marcelo-carvalhop/iot-over-can/Documentacao/historico/README.md

# Histórico

Documentos de etapas anteriores do projeto, guardados como foram escritos, sem revisão. Podem citar arquivos, comandos e comportamentos que já mudaram e caminhos que não existem mais. A documentação em vigor está em [`Documentacao/`](../).

| Documento | Conteúdo |
|---|---|
| [`bancada-fisica-2026-10-08.md`](bancada-fisica-2026-10-08.md) | primeira sessão do canal de dados na bancada física |
| [`auditoria-integrada-2026-10.md`](auditoria-integrada-2026-10.md) | auditoria de robustez de outubro de 2026 |
| [`proposta-comissionamento-de-sensores.md`](proposta-comissionamento-de-sensores.md) | proposta, não implementada, de entregar a chave ao sensor pela rede |
| [`simulacao-etapas-2-e-3.md`](simulacao-etapas-2-e-3.md) | laboratório virtual: TUI ligada à bancada e topologia mutável |
| [`simulacao-studio-etapa-4.md`](simulacao-studio-etapa-4.md) | Simulation Studio |
| [`simulacao-ponte-usb-etapa-5.md`](simulacao-ponte-usb-etapa-5.md) | ponte USB para sensores reais |
| [`simulacao-ponte-usb-fft-etapa-6.md`](simulacao-ponte-usb-fft-etapa-6.md) | espectro do sensor acústico pela ponte USB |
| [`simulacao-iniciar-laboratorio.md`](simulacao-iniciar-laboratorio.md) | lançador do laboratório em três terminais |
| [`tui-historico-etapa-1.md`](tui-historico-etapa-1.md) | histórico de sessões na estação |
| [`tui-capturas-etapa-2.md`](tui-capturas-etapa-2.md) | capturas de contexto na estação |
| [`img/`](img/) | capturas de tela de uma versão anterior da estação |
