marcelo-carvalhop/iot-over-can/Documentacao/desafios.md

# Desafios e resoluções

Problemas técnicos que já apareceram no projeto, com a causa e a solução. Serve para entender decisões que, vistas isoladamente, parecem excesso de cuidado, e para reconhecer um problema que volte a aparecer.

Cada problema tem um número `CH-` único. Entram aqui problemas com impacto na arquitetura, no protocolo, na segurança, na compilação ou na operação; observações passageiras de bancada ficam no registro da sessão, em `historico/`.

| ID | Problema | Causa | Solução aplicada | Estado |
|---|---|---|---|---|
| CH-001 | DTCs conhecidos apareciam como desconhecidos | catálogo incompleto na TUI | catálogo explícito e fallback por categoria | Resolvido |
| CH-002 | bateria não instrumentada parecia 100% | sentinelas interpretadas como valor real | `255` e `65535` tratados como N/A | Resolvido |
| CH-003 | TUI dependia de porta serial no boot | inicialização acoplada ao transporte | inicialização offline e conexão posterior | Resolvido |
| CH-004 | IDs de Nodes podiam ser duplicados por build incorreto | valor de ID dependia de edição manual | ID explícito por script/`IOT_NODE_ID` | Resolvido |
| CH-005 | comandos mutáveis dependiam apenas da TUI | firmware aceitava ações locais sem sessão | `AUTH UNLOCK` e lease de administração no sensor | Resolvido |
| CH-006 | segredos estavam sujeitos a configuração inconsistente | múltiplas fontes e ausência de validação | `.env.local`, `security.json` 0600 e script de provisionamento | Resolvido |
| CH-007 | build do Pico W falhava ao ligar BTstack | configuração de hexdump ausente | `ENABLE_PRINTF_HEXDUMP` no `btstack_config.h` | Resolvido |
| CH-008 | Probe não respondia à autodetecção textual | parser aceitava apenas comandos CAN hexadecimais | `PROBE_VERSION` e `PROBE_STATUS` | Resolvido |
| CH-009 | EventLog era poluído por manutenção e telemetria | estado contínuo tratado como evento | classificação de manutenção e painel dedicado de Nodes | Resolvido |
| CH-010 | abertura serial podia produzir fragmentos e bytes NUL | dados residuais e handshake rápido demais | limpeza do buffer, atraso de estabilização e sanitização de entrada | Mitigado |
| CH-011 | associação wireless precisava preservar a escolha explícita do operador | um mesmo UUID pode ser visto por vários Nodes com RSSI diferente | vínculo lógico comandado pela TUI, confirmação pelo CAN e lease de presença por BLE; vínculos gravados na NVS (CH-069) | Resolvido |
| CH-012 | CAN ainda usa MCP2515 clássico | hardware CAN FD ainda não integrado | permanecer em CAN clássico por ora; segmentação em quadros maiores e mensagem autenticada preparadas em biblioteca ([Arquitetura](arquitetura.md#9-preparação-para-can-fd)) | Decidido |
| CH-013 | filho wireless aparecia `STALE/LOST` apesar de o Node continuar recebendo advertisements | TUI e Node CAN calculavam liveness de forma independente, e o lease BLE de 6,5 s era agressivo | Node CAN tornou-se autoridade de liveness, lease ajustado para 15/45 s, filtro de duplicatas desabilitado e watchdog de scan | Resolvido |
| CH-014 | TUI acumulava informação simultânea e dependia de atalhos/comandos pouco visíveis | topologia, telemetria, configuração, eventos e comandos disputavam a mesma tela; ações equivalentes existiam em vários caminhos | telas cheias por assunto, barra contextual, catálogo único de comandos, mensagens opcionais, layout responsivo e gerenciamento wireless visível em `F7/w` | Resolvido |
| CH-015 | ações de telemetria/configuração pareciam disponíveis para filho wireless associado sem existir canal Pico W ↔ Node | associação lógica foi confundida com plano de dados | a TUI distingue vínculo de plano de dados, mostra o estado deste e só oferece as ações enquanto o Node informa sessão autenticada | Resolvido |
| CH-016 | lista `wireless-available` excedia a largura em 48, 60 e 100 colunas | a mensagem do estado vazio `Nenhum sensor sem fio disponível foi observado nos últimos 15 s.` possui exatamente 64 células; as primeiras correções atuaram nos prompts de candidatos e não atingiram esse item `__empty__` | estado vazio dividido em duas linhas curtas, mantendo a informação dos 15 s; candidatos e vínculos continuam compostos por linhas semânticas curtas | Resolvido |
| CH-017 | sensor associado não tinha como saber qual Node o assumiu | a associação é decidida entre Probe e Nodes pelo CAN; o Pico só anuncia | o Node responsável anuncia por BLE uma oferta assinada com a chave do sensor; SSID e senha do ponto de acesso são derivados localmente, sem conexão GATT nem credenciais no ar | Funcionou em bancada física (08/10/2026) |
| CH-018 | UUID e RSSI não provam identidade | qualquer dispositivo pode anunciar o UUID de um sensor | autenticação mútua por desafio-resposta com HMAC-SHA256 e chave por dispositivo; sessão com contador anti-replay; caminho UDP sem autenticação removido | Funcionou em bancada física (08/10/2026) |
| CH-019 | um ponto de acesso tem uma única senha, mas cada sensor precisa de chave própria | WPA2-PSK não distingue estações | duas chaves derivadas da mestra: `K_net` para o acesso à rede e `K_dev` para a identidade, verificada na camada de aplicação | Implementado |
| CH-020 | telemetria e espectro não cabem em um quadro CAN clássico, e o driver do MCP2515 guarda poucos quadros | 50 a 177 bytes por mensagem contra 8 bytes por quadro | transporte segmentado com CRC-8 em identificador próprio por Node, fila de transmissão escoada pelo laço principal e espectro reduzido somente sob pedido | Funcionou em bancada física (08/10/2026) |
| CH-021 | dados de sensores poderiam atrasar eleição e liveness | CAN arbitra por identificador | faixa `0x380`–`0x39F`, a de menor prioridade do projeto, reservada ao plano de dados | Implementado |
| CH-022 | HELLO autêntico repetido poderia derrubar a sessão do sensor legítimo | um novo handshake substituía a sessão ao ser iniciado | handshake pendente separado da sessão em vigor; a troca só ocorre após CONFIRM autenticado | Implementado |
| CH-023 | TUI aberta depois do BIND não conhecia os vínculos | estado de associação publicado apenas em transições | Node republica o estado de cada vínculo a cada 10 s | Implementado |
| CH-024 | lógica dos firmwares só podia ser exercitada com hardware | rádio, UDP e CAN acoplados ao código | biblioteca portátil `ioc_link` testada no computador e simulação que executa `wireless_link.cpp` com periféricos substituídos, ligada aos testes da TUI | Implementado |
| CH-026 | dados de sensores podiam bloquear ou derrubar quadros de controle do próprio Node | o buffer de transmissão do MCP2515 é único, FIFO e os demais emissores não conferem se há espaço | o plano de dados só acrescenta quadros com menos de 4 pendentes no controlador; pausa entre blocos de espectro; buffer de recepção ampliado para 128 quadros | Implementado; validação em bancada pendente |
| CH-027 | incluir o diretório do firmware do Pico no build do ESP32 substituiria o `lwipopts.h` do ESP-IDF | os dois firmwares compartilham `edge_protocol_definitions.h`, que fica ao lado do `lwipopts.h` do Pico | inclusão por caminho relativo em `wireless_link.cpp`, sem `-I` | Implementado |
| CH-028 | perda do menu de configuração deixava a configuração remota travada | o sensor enviava o menu uma única vez por sessão e edições pendentes impediam a atualização | o Node pede o menu a cada sessão e quando não o conhece; edições são descartadas em nova sessão, recusa ou tempo esgotado | Implementado |
| CH-025 | BLE + Wi-Fi excedem a partição de aplicação padrão do ESP32 | 1,3 MB insuficientes para as duas pilhas | `board_build.partitions = min_spiffs.csv` | Resolvido: o firmware da versão 0.18 ocupa 1,06 MB dos 1,9 MB da partição |
| CH-029 | a rede dependia da Probe 00 para se recuperar da falta do líder | só a Probe contava o tempo sem sinal de presença e pedia a eleição | cada seguidor vigia o líder (6 períodos, escalonado pelo identificador); a Probe continua reagindo antes, com 4 | Implementado; validação em bancada pendente |
| CH-030 | seguidores ficavam órfãos quando um líder travado retomava | o seguidor ignorava o sinal de presença de qualquer líder diferente do que seguia; deixava de transmitir e era declarado ausente | o seguidor adota o líder de maior identificador, a mesma regra que os líderes já usavam entre si | Implementado; validação em bancada pendente |
| CH-031 | um líder que voltava de uma parada declarava todos os seguidores ausentes | o tempo em que o próprio laço ficou parado era contado como silêncio dos outros | o Node que percebe a parada do próprio laço rearma as vigilâncias | Implementado; validação em bancada pendente |
| CH-032 | a Probe 00 pedia uma segunda eleição durante uma eleição pedida por um seguidor | a contagem de falta de sinal de presença continuava durante a eleição alheia | a Probe reconhece a eleição em curso e aguarda o novo líder | Implementado; validação em bancada pendente |
| CH-033 | um sensor entregando dados podia ser dado como perdido | a presença dependia só dos anúncios BLE, e o rádio do Node divide o tempo com o ponto de acesso | uma sessão de dados autenticada conta como presença do sensor | Implementado; validação em bancada pendente |
| CH-034 | a perda do Node responsável deixava o sensor sem caminho até o operador intervir | o vínculo era fixo e ficava em memória no Node | reassociação automática, autorizada por sensor, decidida pelo líder com as observações de RSSI que já trafegam no barramento | Funcionou uma vez em bancada física (08/10/2026); tempos a medir |
| CH-035 | a primeira versão da decisão de reassociação escolhia o próprio Node que havia saído do ar | a última observação BLE feita por ele antes da falha ainda era recente | a observação do responsável só conta se for bem posterior ao último estado que ele publicou (sinal de que reiniciou) | Resolvido; encontrado na bancada virtual |
| CH-036 | não havia como medir ocupação do barramento nem período das mensagens | o MCP2515 entrega apenas identificador, DLC e dados | a Probe reconstrói CRC-15 e bits de preenchimento de cada quadro e soma a duração exata; período por identificador a partir do instante de retirada da fila | Implementado; a variação medida inclui a latência do laço da Probe (cerca de 1 ms) |
| CH-037 | a lógica distribuída só podia ser exercitada com vários ESP32 na bancada | eleição, vigilâncias e reassociação dependem de vários Nodes ao mesmo tempo | bancada virtual: o firmware completo compilado uma vez por Node, cada cópia em seu namespace, com barramento, rádios e sensores simulados | Implementado; 19 cenários na validação nativa |
| CH-038 | "Última ação" da TUI era sobrescrita a cada segundo | o sinal de presença do líder era gravado como ação do operador | o sinal de presença deixou de alterar esse campo; líder e períodos ficam na tela de métricas | Resolvido |
| CH-039 | a análise de tempo de resposta clássica subestima o pior caso | a formulação de 1995 examina só a primeira instância do período ocupado | uso da análise revisada de Davis et al. (2007), verificada com o exemplo do artigo; rajadas tratadas como quadros liberados juntos | Implementado |
| CH-040 | uma reassociação por perda de alcance podia deixar o sensor sem responsável | o líder desfazia o vínculo anterior antes de o novo Node confirmar; um Node que aceitava o pedido sem ouvir o sensor ficava parado em `ASSOCIATING` | o líder só pede a nova associação; o responsável anterior cede ao ouvir o novo publicar o vínculo; o Node que não ouve o sensor em 15 s publica `STALE` e o líder escolhe outro | Resolvido; cenários `failover_retry` e `failover_dead_target` |
| CH-041 | o intervalo mínimo entre decisões não valia quando o responsável mudava | a contagem era reiniciada a cada troca de responsável | o intervalo de 30 s é por sensor, qualquer que seja o responsável | Resolvido; teste na biblioteca e na bancada virtual |
| CH-042 | um líder que retomava de uma parada longa podia reassociar um sensor que funcionava | a tabela de vínculos e observações envelhecia enquanto o laço estava parado | ao perceber a parada do próprio laço, o Node reinicia a contagem de silêncio dos vínculos e descarta as observações; o enlace é atualizado antes da decisão no laço | Resolvido; cenário `silence_leader_with_sensor` |
| CH-043 | amostras não encaminhadas apareciam como perdidas | a linha `TEL` levava a sequência do sensor, e o Node encaminha só uma amostra por período | o Node numera as amostras que encaminha; um salto passa a indicar perda no barramento ou na remontagem | Resolvido na 0.18; a 0.17 mostra a perda aparente |
| CH-044 | Probe 00 e líder transmitiam nos mesmos identificadores de associação | os pedidos de reassociação reutilizavam `0x300`/`0x301`; dois transmissores no mesmo identificador podem colidir sem arbitragem | o líder usa `0x302`/`0x303`; cada par só aceita as ações do seu emissor | Resolvido |
| CH-045 | a carga de baixa prioridade usava um identificador inválido | `0x7F0` tem os sete bits mais significativos recessivos, o que o CAN proíbe | uso de `0x7EF`, o identificador válido de menor prioridade | Resolvido |
| CH-046 | um Node podia ficar mudo depois de um ensaio | a volta do modo somente escuta para o modo normal não era conferida | o pedido é repetido a cada 100 ms até o controlador confirmar; a entrada no modo é tentada três vezes e o ensaio é recusado se falhar | Implementado; validação em bancada pendente |
| CH-047 | o ponto de acesso não voltava se a primeira tentativa de religá-lo falhasse | a religação era tentada uma única vez | nova tentativa a cada 5 s enquanto houver vínculo e o ponto de acesso estiver desligado | Implementado; validação em bancada pendente |
| CH-048 | a análise de tempo de resposta acusava prazos perdidos que não existiam | respostas a um comando isolado eram lidas como tráfego periódico de alguns milissegundos; um ciclo perdido virava variação de liberação | episódios isolados viram uma rajada por janela; o período é o menor intervalo entre chegadas; o tamanho das rajadas é apresentado como estimativa | Resolvido |
| CH-049 | comandos CAN escritos de outra forma passavam sem autorização na TUI | a Probe lê os quatro bytes com `sscanf("%hhx")`, que aceita `0`, `0x22`, sinal e dígitos a mais; a TUI comparava o texto | a TUI refaz a leitura como o firmware e autoriza pela forma canônica | Resolvido |
| CH-050 | as gravações da bancada virtual não entravam no repositório | `.gitignore` ignora `*.log` | exceção para `Front/replays/*.log`, conferida por teste | Resolvido |
| CH-051 | as medições de uma reprodução usavam o relógio da máquina como origem | o serviço de métricas era criado antes de a reprodução começar | métricas e registrador de ensaios são reiniciados no primeiro instante da gravação | Resolvido |
| CH-052 | o maior intervalo sem telemetria dependia da ordem das linhas | a contagem começava na primeira amostra recebida depois do início do ensaio | a última amostra de cada sensor é acompanhada também fora dos ensaios; valores não observados não são preenchidos com zero | Resolvido |
| CH-053 | os ESP32 não se mantêm ligados alimentados por um power bank de 2000 mAh | provável limite de corrente da saída: com varredura BLE contínua e ponto de acesso Wi-Fi ligado, os picos somados de três placas passam de 1 A, sobretudo quando ligam juntas; a capacidade útil em 5 V dá cerca de duas horas | confirmar pelo motivo de reinício no monitor serial; usar fonte de 5 V com 3 A ou mais na bancada; monitoramento da alimentação e ajustes de consumo planejados ([Arquitetura](arquitetura.md#10-limites-conhecidos-e-evoluções-previstas)) | Resolvido na bancada com um hub USB com fonte própria (Acasis) |
| CH-054 | a TUI mostrava "ida e volta de 0,0 ms" para um enlace sem sessão | o relatório enviado quando o Node libera um vínculo levava o tempo de ida e volta zerado, e não o valor "sem medida" | o relatório passa a levar "sem medida" | Resolvido; observado na primeira bancada física |
| CH-055 | não havia como saber, na bancada física, em que passo a sessão entre sensor e Node parava | nem o Node nem o sensor registravam as etapas do enlace | o Node escreve no monitor serial cada passo (`[WLINK]`: oferta, estação conectada, endereço entregue, HELLO e o resultado da conferência); o sensor escreve no console (`[NET]`: oferta, estado do Wi-Fi, endereço, HELLO, datagramas recebidos, recusas e sessão) | Implementado |
| CH-056 | Nodes e sensor foram gravados sem chave de enlace sem que o operador percebesse | o `.env.local` vinha de uma versão anterior, sem a chave mestra; o script de credenciais não altera arquivos existentes e os scripts de compilação apenas avisam | `provision_sensor_security.sh --check` aponta a falta e `--add-link-key` a acrescenta; a entrega da chave sem compilação está proposta em [`historico/proposta-comissionamento-de-sensores.md`](historico/proposta-comissionamento-de-sensores.md) | Contornado; observado na primeira bancada física |
| CH-057 | uma placa gravada pelo botão do editor saía com o número de Node 4 | `tools/node_id.py` usava 4 quando `IOT_NODE_ID` não era informado; duas placas assim disputam os mesmos identificadores CAN e o mesmo ponto de acesso | a compilação sem `IOT_NODE_ID` para com erro e indica o script | Resolvido |

## Sensor acústico INMP441

Problemas encontrados ao acrescentar o segundo tipo de sensor wireless (`Codigo/node-audio`, ver [Sensor acústico](sensor-acustico.md)).

| ID | Problema | Causa | Solução aplicada | Estado |
|---|---|---|---|---|
| CH-058 | o segundo sensor exigiria copiar a pilha de rede do primeiro | enlace, BLE, sessão e DTCs estavam misturados ao código do acelerômetro | módulos comuns em `Codigo/node-wifi` e ganchos em `edge_app.h`, resolvidos na ligação; cada sensor implementa os seus | Implementado; o sensor de vibração não mudou de comportamento |
| CH-059 | RP2040 e RP2350 não têm periférico I2S | o INMP441 só fala I2S | I2S mestre na PIO, com SCK e WS por *side-set* e leitura só nas bordas de subida; DMA encadeado em anel | Implementado; verificado por simulação ciclo a ciclo, bancada pendente |
| CH-060 | o primeiro quadro I2S saía deslocado de um ou dois bits | a máquina de estados começava no início do programa, fora da fase do quadro | ponto de entrada na instrução certa e estado inicial de SCK e WS forçado antes de habilitar a máquina | Resolvido; encontrado na simulação da PIO |
| CH-061 | PIO e DMA fixos colidiriam com o rádio | o driver CYW43 também usa uma máquina de estados e canais de DMA | reserva dinâmica, feita depois de o rádio reservar os dele | Implementado |
| CH-062 | o RP2040 não acompanha uma FFT por quadro a taxas altas | o Cortex-M0+ emula ponto flutuante | níveis integrados no tempo, sem lacunas; ponderações A e C pela razão medida nos quadros analisados; FFT dispensada conforme o atraso do DMA, com a cobertura informada | Implementado; ocupação a medir em bancada |
| CH-063 | o número do modo é ambíguo entre sensores | 1 é `ROTATING` no acelerômetro e `LEVEL` no microfone | o perfil viaja no HELLO e na configuração; o Node recusa o modo do perfil errado e a TUI nomeia os modos pelo perfil | Implementado |
| CH-064 | a fundamental não era encontrada em sinais com muitos harmônicos | a referência de ruído incluía os harmônicos vizinhos | piso medido nos vales entre harmônicos e proeminência pela mediana; a faixa de busca (a partir de 4 faixas) é mostrada na TUI | Resolvido |
| CH-065 | reconfigurar o DSP no RP2040 acusava perda de áudio | recalcular janela e ponderações leva décimos de segundo, e o anel de DMA enchia nesse meio-tempo | o áudio acumulado durante a reconfiguração é descartado sem contar como perda | Resolvido |
| CH-066 | gravações da bancada virtual precisam ser idênticas em qualquer máquina | funções como `pow` e `log` podem diferir no último bit entre bibliotecas | o sensor acústico simulado usa níveis e incrementos de dose tabelados e só aritmética básica | Implementado |

## Robustez da TUI

| ID | Problema | Causa | Solução aplicada | Estado |
|---|---|---|---|---|
| CH-067 | uma linha `TEL` com `SEQ` negativo (corrompida) era descartada sem aviso | o rastreador de sequência recusa valores fora de 0..65535 com exceção, e o barramento de eventos só registrava a falha no `logging` | o controlador confere a faixa: a amostra vale, a contagem de perdas ignora o número e a linha conta como erro de decodificação, com aviso | Resolvido; encontrado por fuzz das gravações da bancada virtual |
| CH-068 | falhas em tratadores de eventos não chegavam ao operador | o barramento isola cada tratador e registrava a exceção só no `logging` do Python | a falha vira mensagem de erro da fonte `INTERNO`, no máximo uma vez a cada 30 s por tratador e tipo de exceção | Implementado |
| CH-069 | um Node reiniciado perdia os vínculos; com política manual, o operador precisava associar de novo | a tabela de vínculos existia só na RAM | tabela gravada na NVS a cada mudança e retomada depois de 12 s ouvindo a rede; o que outro Node assumiu na ausência é descartado e o vínculo retomado sem sessão cede em disputa (`ioc_bindstore`, cenário `restart_keeps_binding`) | Implementado; validação em bancada física pendente |

## Bancada virtual com sensor físico (ponte USB)

| ID | Problema | Causa | Solução aplicada | Estado |
|---|---|---|---|---|
| CH-070 | a FFT do sensor acústico físico nunca chegava pela ponte USB do Studio: a ponte registrava `FFT VALID=NO` três vezes seguidas, com `SPECTRUM_VALID=YES` na telemetria, e o Node rejeitava o pedido por `SENSOR_TIMEOUT` | o console do Pico ecoa o que é digitado; a linha de eco `FFT ONCE` começa com `FFT ` e era tomada por resposta inválida. Cada nova tentativa gerava outro eco, e a ponte desistia em milissegundos, antes de a linha `FFT VALID=YES` sair no relatório seguinte do DSP (até 1 s depois) | só `FFT VALID=YES` ou `FFT VALID=NO` conta como resposta; eco e `OK FFT_ONCE` são reconhecidos; nova tentativa só para um `VALID=NO` de verdade e se o relatório seguinte couber no prazo do Node; linha truncada ou recusa do simulador não encerram mais a ponte; teste que emula o console byte a byte (`Simulacao/tests/test_usb_fft_console_echo.py`) | Resolvido; verificado com o simulador e um Pico emulado, bancada física pendente |
| CH-071 | com o sensor acústico físico na ponte USB, a TUI ocultava frequência dominante, centroide e planura, e a janela alternava entre 1024 e 512 | a ponte não repassava `SPECTRUM_VALID`, e o sensor virtual só marcava o espectro como válido (e trocava `WIN` pelo tamanho do vetor) na amostra que levava a FFT; o firmware real marca todo relatório com FFT calculada e mantém a janela do DSP | a ponte envia o indicador como `FFT_VALID` (chave já aceita por simuladores anteriores) e o sensor virtual mantém `WIN` | Resolvido; exige recompilar o simulador |

## Abertura do canal de dados wireless

Esta foi a dificuldade de implementação mais demorada do plano de dados. O registro completo está aqui porque as causas se combinam e porque o caminho até elas explica decisões que, isoladas, parecem excesso de cuidado.

**Sintoma.** Na primeira bancada física com o plano de dados, o vínculo pelo BLE (`BIND`) se completava em segundos. Já a sessão autenticada entre o sensor e o Node, e com ela a telemetria, levava mais de 20 minutos em muitos casos. Com mais de um sensor no mesmo Node, podia não abrir nunca. A TUI só mostrava o estado do enlace (`OFFERING`, `HANDSHAKE`): o operador não sabia se a criação avançava, estava parada ou falhava.

**Por que foi difícil:**

- Não havia um componente com defeito. Eram três decisões razoáveis isoladamente que, juntas, só falhavam com o rádio disputado. Em bancada silenciosa, com um sensor e sem atraso, o handshake abria normalmente.
- O sintoma apontava para o lugar errado. "O handshake não dispara" sugeria um defeito no início da troca, mas o HELLO saía e o Node respondia; o que se perdia era a resposta atrasada. Duas hipóteses foram investigadas e descartadas: o filtro de duplicatas do BTstack descartando ofertas (vem desligado) e uma conferência de ordem crescente no nonce da oferta (não existe).
- O ESP32 divide um único rádio, e a mesma antena, entre BLE e Wi-Fi. A Espressif classifica ponto de acesso com estação conectando ou conectada + BLE como "suportado, desempenho instável". O atraso depende do ambiente e da carga, e muda de uma execução para outra.
- A bancada virtual entregava cada datagrama no mesmo passo da simulação, então a corrida não aparecia. Foi preciso modelar o atraso do rádio (`g_radio_delay_ms`) para reproduzi-la.
- Para localizar a etapa, era preciso ler ao mesmo tempo o monitor serial de cada Node e o console do sensor (CH-055). Entre o vínculo e a sessão, a TUI não mostrava nada.

**Causas.** As três ficam no mesmo caminho e se reforçam:

1. **Nonce trocado a cada HELLO.** O sensor repete o HELLO a cada 1,5 a 3,5 s até receber o CHALLENGE e gerava um nonce novo em cada repetição. O CHALLENGE ecoa o nonce do HELLO a que responde. Quando a resposta demorava mais que o intervalo até a repetição seguinte, chegava com o eco de um nonce já trocado e era descartada. A sessão só abria quando, por acaso, um CHALLENGE chegava antes da próxima repetição: daí as dezenas de minutos. Com o atraso acima de 3,5 s, não abria nunca.
2. **Varredura BLE do Node em 50 % do rádio.** Ela continuava enquanto o sensor entrava no ponto de acesso. Atraso e perda cresciam justamente durante a associação Wi-Fi, o DHCP e o handshake.
3. **Oferta reiniciada a cada 400 ms.** O anúncio BLE era parado e religado a cada rodízio, mesmo com um só sensor esperando. Com vários sensores, há mais reinícios, mais HELLOs repetidos e mais disputa de rádio, o que agrava a causa 1. Por isso a sessão podia nunca abrir.

**Solução.** O nonce passou a valer pela tentativa inteira. A varredura BLE cai para 25 % enquanto houver sensor sem sessão. A oferta deixou de ser reiniciada com um só sensor e sai do ar durante a autenticação (CH-072). No cenário `handshake_slow_radio` da bancada virtual, com 3,6 s de atraso, a versão anterior não abria sessão; a nova abre em cerca de 5 s depois do vínculo, para cada um de dois sensores no mesmo Node.

Para que uma espera longa deixe de ser uma caixa-preta, o Node passou a relatar as etapas ao CAN, e a TUI as mostra na tela do sensor (CH-073). Um operador agora distingue "o sensor não entrou na rede", "a chave não confere" e "o CHALLENGE ficou sem resposta" sem abrir o monitor serial.

**O que falta.** Validar na bancada física. Os pontos a medir são:

- o tempo entre o vínculo e a sessão, com um e com dois sensores; a seção **Criação do canal de dados** mostra os segundos de cada etapa desde o vínculo;
- se ainda aparece `CHALLENGE sem resposta`;
- se a associação Wi-Fi ainda falha com a varredura em 25 %. Se falhar, o próximo passo é reduzir `SCAN_WINDOW_QUIET` em `wireless_discovery.cpp`.

**Lições:**

- Num desafio-resposta sobre rádio disputado, a identidade da tentativa (o nonce) precisa sobreviver às retransmissões: retransmitir não é recomeçar.
- Uma simulação sem atraso de rádio esconde corridas. O atraso deve fazer parte da bancada desde o início.
- Um processo com várias etapas precisa ser observável onde o operador está, e não apenas na serial do equipamento.

| ID | Problema | Causa | Solução aplicada | Estado |
|---|---|---|---|---|
| CH-072 | na bancada física, a sessão entre sensor e Node levava mais de 20 min para abrir, e com mais de um sensor podia não abrir; o vínculo BLE existia, mas o handshake não avançava | três fatores no mesmo caminho: (1) o sensor trocava o nonce a cada repetição do HELLO, então todo CHALLENGE atrasado mais que o intervalo entre HELLOs chegava com o eco de um nonce já trocado e era descartado; (2) o Node mantinha a varredura BLE em 50 % do rádio enquanto o sensor tentava entrar no ponto de acesso (a Espressif classifica ponto de acesso com estação conectando + BLE como instável no ESP32); (3) a oferta era parada e religada a cada 400 ms mesmo com um único sensor esperando | nonce mantido durante a tentativa (refeito em nova associação, depois de sessão ou a cada 8 HELLOs sem resposta); varredura BLE do Node em 25 % enquanto há sensor sem sessão; oferta sem reinícios com um sensor e fora do ar durante a autenticação; atraso de rádio na bancada virtual e cenário `handshake_slow_radio` (com 3,6 s de atraso a versão anterior não abria sessão; a nova abre em cerca de 5 s, com dois sensores) | Implementado; validação em bancada física pendente |
| CH-073 | com o canal de dados demorando a sair, o operador não sabia se havia um problema nem em que etapa a criação estava | o Node só publicava o estado do enlace (`OFFERING`, `HANDSHAKE`, `SECURE`); os fatos que explicam a espera (estação no ponto de acesso, HELLO recusado e por quê, CHALLENGE sem resposta) saíam apenas na serial do próprio Node | relato das etapas ao CAN (tipo `10`, `[GW] WIRELESS_EVENT`), agrupado e sem tomar a fila da telemetria; na TUI, seção **Criação do canal de dados** na tela do sensor, com etapa atual, tempo de espera, motivo da falha e o que verificar, linha da etapa na tela inicial e relatos em Mensagens | Implementado; validação em bancada física pendente |
| CH-074 | o painel em papel colorido (PaperColor) não acompanhava a rede: cada redesenho levava de 15 a 30 s e os alertas dependiam dos LEDs e dos bipes | o E Ink Spectra 6 foi feito para imagens estáticas, não para um painel de operação | o painel passou para a ESP32-2432S028 (LCD 320×240 com toque): mesmo `PanelApp`, HAL e página compacta próprios (`node-paper/src/cyd`), redesenho só do que mudou; o PaperColor passou a ser o leitor da documentação (`Codigo/leitor`), uso em que o desenho lento não atrapalha | Implementado; validação em bancada física pendente |
| CH-075 | o histórico registrava o que acontecia, mas não quem fez: não havia como saber quem alterou a rede ou autorizou a entrada de um sensor | a estação não identificava quem a operava, e a chave física (FIDO2), que serviria para isso, ainda não está implementada; a YubiKey no modo `presence` prova que há uma chave conectada, não quem a usa | identificação por senha na estação (cadastro com `scrypt`, sessão que expira por inatividade, perfis operador e observador), com o usuário do sistema como alternativa quando não há cadastro; cada ação que altera a rede vai para a faixa AUDIT do histórico com o autor, encadeada por hash para revelar registros adulterados; a resposta do firmware a uma associação é creditada a quem a pediu; `Actor.method` deixa o lugar do FIDO2 pronto | Implementado; coberto por testes automatizados, sem hardware |
