marcelo-carvalhop/iot-over-can/Documentacao/estrutura-do-projeto.md

# Estrutura do projeto

A organização separa interface, firmware, scripts operacionais e documentação oficial.

```text
iot-over-can/
├── Front/
│   ├── pico_tui/
│   │   ├── core/
│   │   ├── metrics/
│   │   ├── protocol/
│   │   ├── services/
│   │   ├── app.py
│   │   ├── screens.py
│   │   ├── metrics_screens.py
│   │   ├── dialogs.py
│   │   ├── widgets.py
│   │   ├── presentation.py
│   │   ├── command_catalog.py
│   │   ├── spectrum.py
│   │   ├── preferences.py
│   │   ├── palette.py
│   │   ├── security.py
│   │   ├── serial_client.py
│   │   └── app.tcss
│   ├── replays/
│   ├── tests/
│   ├── pyproject.toml
│   └── README.md
├── Codigo/
│   ├── common/
│   │   ├── ioc_link/
│   │   └── tests/
│   ├── node-can/
│   │   ├── include/
│   │   ├── src/
│   │   ├── test/host/
│   │   ├── tools/
│   │   └── platformio.ini
│   ├── node-wifi/
│   │   ├── tests/
│   │   ├── CMakeLists.txt
│   │   └── fontes do firmware
│   ├── node-audio/
│   │   ├── tests/
│   │   ├── CMakeLists.txt
│   │   └── fontes do sensor acústico
│   └── scripts/
├── Documentacao/
│   ├── arquitetura/
│   │   ├── arquitetura.md
│   │   ├── plano-de-dados-wireless.md
│   │   ├── metricas-e-ensaios.md
│   │   └── predisposicao-can-fd.md
│   ├── protocolo/protocolo.md
│   ├── interface/
│   │   ├── tui.md
│   │   └── img/
│   ├── modulo-can/modulo-can.md
│   ├── sensor-wireless/sensor-wireless.md
│   ├── sensor-acustico/sensor-acustico.md
│   ├── livro.md
│   └── documentos gerais
├── .github/workflows/
├── README.md
└── MANIFEST.json
```

## `Front/`

Contém a TUI e seus testes. `pyproject.toml` é a fonte única das dependências Python.

Responsabilidades principais:

| Arquivo/pasta | Responsabilidade |
|---|---|
| `app.py` | ciclo de vida, navegação, autorização e execução de ações |
| `screens.py` | telas cheias de contexto |
| `metrics_screens.py` | telas Métricas da rede e Ensaios |
| `dialogs.py` | decisões modais curtas |
| `widgets.py` | componentes responsivos e sem truncamento |
| `presentation.py` | regras de condição, rótulos e formatação |
| `command_catalog.py` | catálogo declarativo de comandos |
| `spectrum.py` | representação FFT (magnitude ou dB SPL) |
| `acoustics.py` | análises do sensor acústico: exposição (NR-15, NHO-01), curvas NC, conversa, tacômetro, eventos e calibração |
| `acoustic_view.py` | campos e textos da tela do sensor acústico |
| `preferences.py` | preferências não sensíveis |
| `palette.py` | identidade Aço industrial |
| `security.py` | autorização da TUI |
| `core/` | modelos, eventos e store |
| `metrics/` | acúmulo das medições (`service.py`), análise de tempo de resposta (`rta.py`), catálogo e medição dos ensaios (`experiments.py`), nomes dos identificadores (`catalog.py`) e exportação (`export.py`) |
| `protocol/` | decodificação dos contratos seriais/CAN |
| `services/` | domínio, demonstração e persistência de log |
| `replays/` | saída da Probe 00 em cada cenário da bancada virtual; entrada dos testes e de `--replay` |
| `tests/` | testes automatizados e contratos |

## `Codigo/common/`

Código C portátil compartilhado pelos dois firmwares e testado no computador.

| Arquivo | Responsabilidade |
|---|---|
| `ioc_link/ioc_sha256.*` | SHA-256 e HMAC-SHA256 |
| `ioc_link/ioc_link.*` | derivação de chaves, oferta de vínculo, envelope autenticado e handshake |
| `ioc_link/ioc_wdata.*` | segmentação no CAN e formatos de telemetria, espectro, confirmação, DTC, enlace, configuração e relatório acústico |
| `ioc_link/ioc_canbits.*` | duração exata de um quadro CAN clássico (CRC-15 e bits de preenchimento), para a medição do barramento |
| `ioc_link/ioc_failover.*` | decisão de reassociação de sensores, sem entrada nem saída |
| `ioc_link/ioc_secpdu.*` | PDU autenticada para o barramento (predisposição; não usada pelo firmware) |
| `tests/test_ioc_link.c` | testes nativos e vetores para conferência com Python |
| `tests/test_ioc_net.c` | testes nativos da medição, da PDU autenticada, da segmentação em quadros maiores e da reassociação |

## `Codigo/node-can/`

Firmware dos ESP32 + MCP2515. Inclui eleição, liveness CAN, função local, descoberta BLE, associação wireless, publicação dos estados do vínculo, o plano de dados dos sensores associados (`wireless_link.cpp`), a medição do barramento na Probe 00 (`net_metrics.cpp`) e os ensaios de falha (`fault_injection.cpp`). `test/host/` contém duas simulações: a que executa `wireless_link.cpp` no computador com rádio, UDP e CAN substituídos, e a bancada virtual (`sim_network.cpp`), que executa o firmware completo de vários Nodes em um mesmo processo. O diretório local `legacy/`, quando existir, é ignorado e não integra build/repositório público.

## `Codigo/node-wifi/`

Firmware do Raspberry Pi Pico W: MPU6050, aquisição, DSP, DTC, BLE advertising e varredura de ofertas, console serial, sessão autenticada com o Node (`edge_network_driver.c`, `edge_link.c`) e segurança. `edge_protocol_definitions.h` é a definição única dos payloads do sensor e também é incluído pelo firmware dos Nodes.

## `Codigo/node-audio/`

Firmware do sensor acústico INMP441, para Pico W e Pico 2 W. `inmp441_i2s.pio`/`.c` geram o I2S na PIO e copiam o áudio por DMA; `audio_core1.c` roda o DSP no núcleo 1; `acoustic_dsp.c` e `audio_fft.c` são C puro, testados no computador; `audio_app.c` implementa os ganchos de `edge_app.h` e o envio dos relatórios; `audio_console.c` é o console USB. O enlace, o BLE, a identidade, a bateria e os DTCs vêm de `Codigo/node-wifi`.

## `Codigo/scripts/`

Scripts de setup da TUI, testes, build, upload e provisionamento. `build_pico.sh --audio` compila o sensor acústico; `extrair_livro.py` reúne os trechos marcados para o livro. `build_network_sim.sh` compila a bancada virtual e `record_network_scenarios.sh` regrava `Front/replays/`. Não contém scripts de inicialização de repositório Git.

## `Documentacao/`

É a fonte pública oficial. Cada assunto possui um documento principal. Imagens específicas da interface ficam em `Documentacao/interface/img/`; não existe árvore paralela `Documentacao/Front`.
