marcelo-carvalhop/iot-over-can/Documentacao/protocolo/protocolo.md

# Protocolo

## CAN de controle

Comandos de quatro bytes usam o formato:

```text
opcode subcomando alvo ação
```

Principais comandos:

```text
22 00 FF 01   iniciar eleição
22 10 ID 00   desativar Node
22 10 ID 11   reativar Node
22 10 ID 33   confirmar falha
22 10 ID 44   limpar falha
22 20 FF 00   consultar status global
22 20 ID 00   consultar status de um Node
22 30 FF 01..05  configurar período do liveness lease
```

Respostas de status usam `23 21 ID código`. Atualizações internas conhecidas, como `23 50`, são tratadas como manutenção de estado e não como erro de parser.

### Falta do líder

A falta do sinal de presença é percebida em dois lugares. A Probe 00 pede uma eleição depois de 4 períodos sem sinal. Cada seguidor faz o mesmo depois de 6 períodos, mais 20 ms por posição abaixo do identificador 31, de modo que o seguidor de maior identificador reage primeiro e a rede não depende da Probe. Um seguidor que recebe o sinal de presença de um líder de identificador maior que o do líder que ele segue passa a seguir o de maior identificador.

## Probe 00

A Probe responde aos comandos textuais:

```text
PROBE_VERSION
PROBE_STATUS
```

Os aliases `VERSION` e `STATUS` podem ser usados durante autodetecção da porta. A resposta contém versão de firmware, protocolo, estado CAN e uptime. A partir da versão 0.18, `PROBE_VERSION` traz também a lista `FEATURES`; na 0.19 ela é `FEATURES=WIRELESS_DATA,ACOUSTIC_DATA,BUS_METRICS,FAULT_INJECTION,FAILOVER`, em que `ACOUSTIC_DATA` indica que o firmware do Node entende o relatório do sensor acústico (tipo 7).

### Métricas do barramento

```text
METRICS ON|OFF|RESET

[GW] BUS_STATS t_ms=... win_ms=1000 frames=... bits=... load=<%> peak=<%> rx_err=... tx_err=... eflg=0x.. rx_peak=... ids=... xfer_ok=... xfer_err=... own=... untracked=...
[GW] ID_STATS id=0x... win_ms=... n=... dlc=... bits=... dt_min_us=... dt_avg_us=... dt_max_us=...
```

`BUS_STATS` sai uma vez por segundo; `ID_STATS`, uma vez a cada 5 s por identificador com tráfego. A ocupação é calculada com a duração exata de cada quadro. Os campos e os limites da medição estão em [`../arquitetura/metricas-e-ensaios.md`](../arquitetura/metricas-e-ensaios.md).

### Ensaios de falha

```text
FAULT POWER_CYCLE|SILENCE|AP_OUTAGE <node> <segundos>
FAULT DROP_SESSION <node>
FAULT LOAD <pct> <segundos> [HIGH|LOW]
FAULT CANCEL [node]

[GW] FAULT_TX kind=... node=... duration_ms=... seq=...
[GW] FAULT_EVENT node=... kind=... state=STARTED|ENDED|REJECTED duration_ms=... seq=... [load_pct=... priority=... frames=... achieved_pct=...]
```

Quadros CAN:

```text
0x305   comando: seq | alvo | tipo | arg0 | duração (2 bytes, unidades de 100 ms) | arg1 | 0xA5
0x306   estado:  seq | node | tipo | estado | duração (2 bytes) | 0 | 0x5A
0x010   carga artificial de alta prioridade (somente a Probe 00 transmite)
0x7EF   carga artificial de baixa prioridade (somente a Probe 00 transmite)
```

Tipos: `1` POWER_CYCLE, `2` SILENCE, `3` AP_OUTAGE, `4` DROP_SESSION, `0x0F` CANCEL. Estados: `1` iniciado, `2` encerrado, `3` recusado. Os Nodes compilados com `IOT_FAULT_INJECTION=0` ignoram `0x305`.

## Relógio da rede

A rede mantém uma hora UTC comum (Probe com `TIME_SYNC` em `FEATURES`). Cada Node e a Probe 00 contam o tempo pelo `millis()` a partir da última hora recebida. Hoje nenhum deles tem relógio de tempo real; o formato já prevê um.

Quadro CAN de 8 bytes, um identificador por transmissor: `0x120 + NODE_ID` (`0x120` é a Probe 00; `0x121..0x13F`, os Nodes). A faixa perde para eleição, controle e sinal de presença e vence todo o tráfego dos sensores. Formato em [`ioc_time.h`](../../Codigo/common/ioc_link/ioc_time.h).

```text
tipo(1) | fonte(1) | segundos UTC (4, LE) | milissegundos (2, LE)
tipo:  1 hora, 2 pedido de hora
fonte: 0 sem hora, 1 terminal, 2 relógio de tempo real (RTC), 3 operador
```

- **Terminal.** A TUI envia `TIME <ms UTC desde 1970>` à Probe 00 ao conectar, se a Probe anuncia `TIME_SYNC`, e a cada 10 minutos. A Probe adota a hora, divulga-a no `0x120` e responde `[GW] TIME_SYNC node=0 fonte=TERMINAL epoch=<s.ms> ajuste_ms=<ms|NA>`. `TIME` sem argumento mostra a hora da Probe.
- **Pedido.** Quem não tem hora a pede 5 s depois da partida; o Node também pede quando um painel quer a hora e ele não tem. O pedido leva a fonte e a hora de quem pede. Respondem a Probe 00 e o líder, se tiverem uma hora que o solicitante adotaria. A Probe relata cada pedido como `[GW] TIME_REQ node=<n>`.
- **Adoção.** A hora recebida é adotada quando não há hora ou quando vem de uma fonte melhor (número menor). Da mesma fonte, só quando difere mais de 50 ms nos Nodes, ou mais de 2 s no painel. Assim cada ressincronização corrige a deriva dos cristais sem que os Nodes fiquem trocando correções.
- **Painel.** O HELLO do painel leva o sinal `IOC_PANEL_HELLO_TIME` (`0x02`) a cada conexão. Se o Node tem hora, responde com o próprio quadro de hora num lote à parte, antes do retrato. Se não tem, pergunta ao barramento, e a resposta chega ao painel no encaminhamento ao vivo, como qualquer quadro. Cada divulgação do terminal também chega ao painel ao vivo. O RTC do PaperColor cede à hora do terminal, e a hora ajustada à mão (`/hora`, `/data`) cede à do terminal e à de um RTC.

## Função local do Node CAN

A telemetria local de demonstração produz um byte `0xAA`. A TUI associa esse valor ao Node físico que o originou. O valor atual, a rodada e a idade da amostra são estado contínuo e não devem produzir eventos repetitivos na tela principal.

## Descoberta BLE

Manufacturer Data do Pico W:

```text
company-id(2) | "IC"(2) | adv-version(1) | profile(1) | protocol(1) | UUID64(8)
```

O perfil `0x01` representa `VIBRATION` (MPU6050) e `0x02`, `ACOUSTIC` (INMP441, desde a versão 0.19; ver [`../sensor-acustico/sensor-acustico.md`](../sensor-acustico/sensor-acustico.md)). O protocolo atual é `6`: o sensor acústico usa o mesmo enlace e acrescenta mensagens próprias de dados, sem mudar o que já existia.

Cada Node CAN envia a observação em dois frames clássicos consecutivos. Para o Node `N`:

```text
0x280 + 2*N      parte A: seq + primeiros 7 bytes do UUID
0x280 + 2*N + 1  parte B: seq + último byte UUID + profile + RSSI + protocol + adv-version
```

A Probe recompõe as duas partes quando a sequência coincide e emite:

```text
WIRELESS_CANDIDATE reporter=N uuid=0x... profile=VIBRATION rssi=-55 protocol=6
```

## Associação wireless

A associação é iniciada pela TUI e transmitida pela Probe 00 por um comando textual:

```text
WIRELESS BIND <node> <uuid> [AUTO]
WIRELESS UNBIND <node> <uuid>
WIRELESS POLICY <node> <uuid> AUTO|MANUAL
```

`AUTO` autoriza o líder a reassociar o sensor a outro Node. O padrão é manual.

O UUID é transportado pelo CAN clássico em dois frames de comando. Cada emissor tem o seu par de identificadores, para que dois equipamentos nunca transmitam no mesmo identificador:

```text
0x300  Probe 00, parte A: seq + target + action + primeiros 5 bytes do UUID
0x301  Probe 00, parte B: seq + target + action + últimos 3 bytes do UUID + 2 bytes sem uso
0x302  líder, parte A: mesmo formato
0x303  líder, parte B: seq + target + action + últimos 3 bytes do UUID + Node de origem + RSSI
```

| Ação | Valor | Emissor | Identificadores |
|---|---|---|---|
| associar | `0x01` | Probe 00 | `0x300`/`0x301` |
| desassociar | `0x02` | Probe 00 | `0x300`/`0x301` |
| associar com política AUTO | `0x03` | Probe 00 | `0x300`/`0x301` |
| política AUTO / MANUAL | `0x04` / `0x05` | Probe 00 | `0x300`/`0x301` |
| reassociar: responsável fora do ar | `0x11` | líder | `0x302`/`0x303` |
| reassociar: sensor fora do alcance do responsável | `0x12` | líder | `0x302`/`0x303` |

Todos os Nodes remontam os comandos; só o Node de destino os executa. Uma ação recebida no par de identificadores do outro emissor é descartada. O líder não envia desassociação: o responsável anterior cede o vínculo quando ouve o novo publicá-lo.

Cada Node publica o estado do vínculo em dois IDs exclusivos. Para o Node `N`:

```text
0x320 + 2*N      estado A: seq + child + state + profile + primeiros 4 bytes UUID
0x320 + 2*N + 1  estado B: seq + child + RSSI + protocol + últimos 4 bytes UUID
```

No byte `state`, o bit 7 indica política AUTO e o bit 6 indica sessão de dados autenticada com o sensor; os seis bits baixos são o estado. `REJECTED` (`0x7F`) é sempre enviado sem indicações. Nodes e Probe 00 anteriores à versão 0.18 não conhecem esses bits: todos os equipamentos do barramento precisam ser atualizados juntos.

Estados de associação:

```text
DISCOVERED → ASSOCIATING → BOUND → ONLINE → STALE → LOST
                                      ↑         │       │
                                      └─────────┴───────┘  novo advertisement
```

`UNBOUND` indica remoção explícita e `REJECTED` indica que o Node não pôde aceitar o vínculo, por exemplo porque o UUID não foi observado recentemente ou porque não há `child_id` livre.

A Probe recompõe o estado e emite uma linha textual para a TUI:

```text
[GW] WIRELESS_ASSOC node=1 child=1 uuid=0xE6616408432B6F39 profile=VIBRATION state=ONLINE rssi=-48 protocol=6 failover=AUTO|MANUAL session=SECURE|NONE
[GW] WIRELESS_FAILOVER uuid=0xE6616408432B6F39 from=1 to=2 reason=OWNER_LOST|SENSOR_LOST rssi=-68
```

A segunda linha registra uma reassociação decidida pelo líder. As regras estão em [`../arquitetura/metricas-e-ensaios.md`](../arquitetura/metricas-e-ensaios.md).

Na operação normal da TUI, `F7`/`w` abre a tela Sensores sem fio. O operador seleciona o UUID, escolhe explicitamente o Node entre as observações recentes e confirma o `BIND`. Para remoção, a TUI envia `UNBIND` e mantém o filho visível até receber `UNBOUND`. Os comandos internos `:bind` e `:unbind` são recursos avançados, não o fluxo principal.

A associação atual é um vínculo lógico de identidade e responsabilidade. A continuidade dos advertisements BLE funciona como lease de presença; uma sessão de dados autenticada também conta como presença, pois o rádio BLE do Node divide o tempo com o ponto de acesso. O Node CAN associado é a fonte autoritativa dos estados `ONLINE`, `STALE` e `LOST`; a TUI não deriva esses estados pela idade local da última mensagem. O lease considera o vínculo `STALE` após 15 s sem advertisement e `LOST` após 45 s. O scanner BLE desabilita explicitamente o filtro de duplicatas e possui watchdog para reinício caso a varredura seja interrompida. O Node republica o estado de cada vínculo a cada 10 s, além das transições, para que uma TUI aberta depois da associação reconstrua a topologia.

## Plano de dados wireless

O vínculo aceito dispara o plano de dados entre o sensor e o Node responsável. O resumo abaixo lista os contratos; a justificativa e o modelo de ameaças estão em [`../arquitetura/plano-de-dados-wireless.md`](../arquitetura/plano-de-dados-wireless.md).

Oferta de vínculo anunciada por BLE pelo Node (Manufacturer Data, 27 bytes):

```text
company(2)=0xFFFF | "IO" | versão | node | UUID64(8) | canal | nonce(4) | tag(8)
```

Datagrama UDP autenticado, porta 4242:

```text
"IL" | versão=6 | tipo | contador(4, LE) | payload | tag(8)

0x01 HELLO      sensor -> Node   chave do dispositivo
0x02 CHALLENGE  Node -> sensor   chave do dispositivo
0x03 CONFIRM    sensor -> Node   chave de sessão
0x10 DATA_UP    sensor -> Node   chave de sessão
0x11 DATA_DOWN  Node -> sensor   chave de sessão
```

Quadros CAN:

```text
0x304        comando: seq | node | filho | opcode | arg0..arg3
0x380 + N    dados do Node N, segmentados:
             filho(3)|tipo(5) , transferência(3)|índice(5) , dados
             índice 0: tamanho total, CRC-8, 4 bytes de dados
```

Tipos de transferência: `1` telemetria, `2` espectro, `3` confirmação de comando, `4` DTC, `5` estado do enlace, `6` configuração, `7` relatório acústico, `8` painel em papel eletrônico, `10` etapa da criação do canal de dados (`9` fica reservado). Opcodes: `0x01` encaminhamento, `0x02` espectro, `0x03` estado, `0x10`–`0x14` preparação de configuração, `0x1F` aplicar, `0x20` limpar DTC, `0x21` controle do sensor acústico.

Linhas trocadas entre a TUI e a Probe 00:

```text
CMD TARGET=NN.CC ACTION=<ação> TX=<id> [CAMPO=valor ...]

TEL NODE=N CHILD=C SEQ=<contador do Node, por amostra encaminhada> MODE=... RMS=... RMS_UNIT=m/s2 ...
FRAG NODE=N CHILD=C TYPE=FFT TRANSFER=... INDEX=... COUNT=... FORMAT=U16_SCALED SCALE=... DATA=<hex>
DTC NODE=N CHILD=C CODE=0x.... SYMPTOM=0x.. SEVERITY=. TS_MS=...
ACK COMMAND=<ação> STATE=ACCEPTED|APPLIED|REJECTED TX=<id> NODE=N CHILD=C DETAIL=... [REASON=...] RTT_MS=...
[GW] WIRELESS_LINK node=N child=C state=DOWN|OFFERING|HANDSHAKE|SECURE|NO_KEY rssi=... age_s=... rx=... auth_fail=... replay=... lost=... stream=ON|OFF period_ms=... rtt_ms=... rtt_max_ms=...
[GW] WIRELESS_CONFIG node=N child=C status=CURRENT|APPLIED|REJECTED mode=... rate_req_hz=... rate_eff_hz=... window=... window_size=... stalta=... gain=... [profile=VIBRATION|ACOUSTIC]
[GW] WIRELESS_EVENT node=N child=C event=<evento> reason=<motivo> count=... value=... stations=... since_s=... [uuid=0x...]
```

### Etapas da criação do canal de dados (tipo `10`, v0.22)

Entre o vínculo e a sessão autenticada, o Node relata ao CAN cada fato que observa, para a TUI mostrar em que etapa a criação está e por que parou. O relato tem 8 bytes (dois quadros):

```text
evento | motivo | quantidade(2) | valor | estações | segundos desde o vínculo(2)   [+ UUID(8)]
```

| Evento | Filho | Quando | `value` |
|---|---|---|---|
| `AP_UP` | sensor | o ponto de acesso subiu, ou o sensor foi associado com ele já no ar | canal |
| `AP_DOWN` | sensor (0 sem sensores) | o ponto de acesso foi desligado; `reason` diz por quê | — |
| `AP_ERROR` | sensor | o ponto de acesso não subiu; nova tentativa em 5 s | — |
| `NO_KEY` | sensor | o Node não tem chave de enlace | — |
| `OFFER` | sensor | primeira oferta BLE deste sensor desde o vínculo ou a última sessão | canal |
| `OFFER_ERROR` | sensor | o anúncio BLE não começou | canal |
| `STATION_JOIN`, `STATION_LEAVE` | 0 | uma estação entrou ou saiu do ponto de acesso | — |
| `STATION_IP` | 0 | a estação recebeu endereço | último octeto |
| `HELLO_OK` | sensor | HELLO conferido, CHALLENGE enviado | último octeto do IP do sensor |
| `HELLO_REJECT` | sensor (0 com `NOT_BOUND` ou `FORMAT`) | HELLO recusado; `reason` diz por quê | último octeto |
| `HANDSHAKE_TIMEOUT` | sensor | o CHALLENGE ficou 5 s sem CONFIRM | último octeto |
| `SESSION_UP` | sensor | sessão autenticada | último octeto |
| `SESSION_DOWN` | sensor | sessão encerrada; `reason` diz por quê | — |

Motivos: `NONE`, `FORMAT`, `NOT_BOUND` (o sensor não está associado a este Node; o relato traz o `uuid`), `KEY` (chave não confere), `PROTOCOL`, `REPLAY` (repetição do HELLO da sessão em vigor), `BUSY` (autenticação anterior em andamento), `SEND` (falha ao enviar o CHALLENGE), `TIMEOUT` (sensor sem dados além do prazo), `UNBOUND`, `SLEEP` (painel dormindo), `TEST` (ensaio), `RADIO_OFF`, `IDLE` (nenhum sensor associado).

O filho `0` marca um fato do Node: o Node não sabe qual sensor entrou no ponto de acesso até ele se apresentar no HELLO. `stations` é o número de estações no ponto de acesso no momento do relato. Fatos repetidos (o mesmo HELLO recusado pelo mesmo motivo, a mesma estação entrando e saindo) são agrupados: o primeiro sai na hora e os seguintes no máximo uma vez a cada 5 s, com `count` igual ao número de ocorrências agrupadas. Os relatos só entram na fila de transmissão do Node quando sobram três lugares, para não tomar o espaço da telemetria.

No formato `U16_SCALED`, cada valor de 16 bits é a fração do pico; a magnitude é `valor × SCALE / 65535`.

<!-- livro:inicio id="acustico-protocolo" capitulo="Sensor acústico INMP441" titulo="Protocolo do plano de dados" -->
### Sensor acústico no plano de dados

O relatório acústico de um segundo (`Payload_AcousticStream`, comando `0x21` do sensor) chega ao CAN como transferência do tipo `7`: 108 bytes, 19 quadros, níveis em centésimos de dB e `-32768` para o que o modo não calcula. A Probe 00 o imprime como

```text
TEL NODE=N CHILD=C SEQ=... GW_TS_MS=... PROFILE=ACOUSTIC MODE=LEVEL|MACHINE|EVENTS ACQ=I2S WIN=... RATE_EFF_HZ=...
    INTERVAL_MS=... COVERAGE_PCT=... CPU_PCT=... SPECTRUM_VALID=... OVERLOAD=... MIC_FAULT=...
    LAEQ_DB=... LCEQ_DB=... LZEQ_DB=... LZPEAK_DB=... LAF_DB=... LAFMAX_DB=... LAFMIN_DB=... CREST=... KURT=...
    PEAK_HZ=... CENTROID_HZ=... FLATNESS=... OCT_DB=b1,b2,...,b10 <chaves do modo> BATT_PCT=... BATT_MV=... DTC=... DTC_COUNT=...
```

em uma linha, com as mesmas chaves do console USB do sensor; chave ausente é valor não calculado e `-` em `OCT_DB` é banda acima de fs/2. As chaves de cada modo estão em [`../sensor-acustico/sensor-acustico.md`](../sensor-acustico/sensor-acustico.md), seção 8.2.

Comandos acrescentados:

```text
CMD TARGET=NN.CC ACTION=CONFIG MODE=LEVEL|MACHINE|EVENTS [RATE_HZ=...] [FFT_SIZE=...] [THRESHOLD=...] [GAIN=...] TX=<id>
CMD TARGET=NN.CC ACTION=MEASURE_RESET TX=<id>
CMD TARGET=NN.CC ACTION=BASELINE_LEARN SECONDS=5..3600 TX=<id>
CMD TARGET=NN.CC ACTION=BASELINE_CLEAR TX=<id>
```

`THRESHOLD` e `FFT_SIZE` são sinônimos de `STALTA` e `WINDOW_SIZE`. O nome do modo define o perfil, levado no argumento 1 do opcode `0x10` (1 vibração, 2 acústico, 0 para `IDLE`): o Node recusa o modo de um perfil enviado ao sensor do outro (`REASON=PROFILE_MISMATCH`, `DETAIL=65533`) e descarta a edição inteira no `APPLY`. As três ações acústicas usam o opcode `0x21` (argumento 0: ação 1, 2 ou 3; argumentos 1–2: segundos) e são confirmadas pelo sensor com `CMD_ACOUSTIC_CONTROL_ACK`; o `DETAIL` da confirmação final é o número da ação. A configuração (tipo `6`) ganhou um byte com o perfil do sensor; a Probe aceita também o formato anterior, de 21 bytes.
<!-- livro:fim id="acustico-protocolo" -->

`RTT_MS` é o tempo entre o envio do comando pela Probe 00 e a chegada da confirmação. `rtt_ms` e `rtt_max_ms` são o tempo de ida e volta entre o Node e o sensor, medido pelo par `PING`/`PONG`; `-1` indica que ainda não há medida. O relatório de estado do enlace (tipo `5`) tem 19 bytes desde a versão 0.18; a Probe aceita também os 15 bytes da versão anterior.

## Sensor wireless — console serial

Comandos de leitura principais:

```text
VERSION
STATUS
NET
AUTH STATUS
FFT ONCE
TELEMETRY ONCE
DTC
```

Comandos que alteram estado exigem uma sessão de manutenção autorizada. A aquisição operacional é `POLLING`; `DRDY` não está habilitado no fluxo atual.

O console do sensor acústico (`EDGE DSP ACOUSTIC CONSOLE`) segue o mesmo formato, com `PROFILE=ACOUSTIC` em `VERSION` e `STATUS`, aquisição `I2S` e os comandos `SET MODE LEVEL|MACHINE|EVENTS`, `SET FFT`, `SET THRESHOLD`, `CAL <dB>`, `MEASURE RESET` e `BASELINE LEARN|CLEAR`; a lista completa está em [`../sensor-acustico/sensor-acustico.md`](../sensor-acustico/sensor-acustico.md).

## Telemetria de vibração

A telemetria pode incluir RMS, excesso de curtose, fator de crista, frequência e amplitude do pico espectral, entropia espectral, PPV, STA/LTA, clipping, bateria, modo, janela, tamanho do buffer e qualidade da FFT.

Bateria `255%` e `65535 mV` representam informação indisponível quando não existe monitor de bateria instrumentado.

## DTCs

| Código | Significado |
|---|---|
| `0x0000` | sem DTC ativo |
| `0x1001` | comunicação I²C com MPU6050 |
| `0x1002` | barramento I²C bloqueado |
| `0x1003` | microfone INMP441 sem dados válidos no I2S (sensor acústico) |
| `0x2001` | condição de gravidade/sensor |
| `0x2002` | clipping do sensor |
| `0x2003` | sobrecarga acústica, acima de ~120 dB SPL (sensor acústico) |
| `0x3001` | overrun do DSP (no sensor acústico: blocos de áudio perdidos) |
| `0x3002` | núcleo de DSP sem progresso (sensor acústico) |
| `0x4001` | baixa tensão |
| `0x4002` | falha de rede Wi-Fi |
| `0x4003` | datagrama com autenticação inválida |
| `0x4004` | versão de protocolo incompatível |
| `0x4005` | datagrama repetido (contador antigo) |
| `0x4006` | configuração inválida recusada |

A TUI deve exibir o código bruto quando receber um DTC ainda não catalogado.

## Fragmentação e integridade

Transferências maiores que um frame podem ser fragmentadas. A TUI mantém timeout, índice, contagem de fragmentos e CRC para remontagem. Fragmentos duplicados ou transferências incompletas são diagnosticados sem corromper o estado já aplicado.
