marcelo-carvalhop/iot-over-can/Documentacao/interface/tui.md

# TUI — interface de operação do iot-over-can

A TUI é a estação de instrumentação e operação da bancada. Ela apresenta o estado mantido pelo domínio, recebe comandos do operador e usa a Probe 00 como acesso ao barramento CAN. A interface não participa da eleição nem substitui a lógica distribuída dos Nodes.

A implementação está em `Front/pico_tui/` e usa Textual 8.2.8, Rich 15.0.0 e pySerial 3.5.

## Objetivos de interface

A TUI segue seis regras principais:

1. **uma tela por assunto**: visão geral, módulo, sensor, comandos, rede, mensagens, sensores sem fio, espectro e ajuda são telas distintas;
2. **operações importantes ficam visíveis**: a barra de teclas mostra as ações disponíveis; associação wireless não depende de um `Ctrl` oculto;
3. **estado antes de detalhe**: a tela inicial responde primeiro se há algo que exige atenção;
4. **nenhuma ação deve fingir suporte inexistente**: sensores wireless associados só recebem telemetria/configuração via Node enquanto o plano de dados tem sessão autenticada;
5. **sem truncamento horizontal**: conteúdo quebra em linhas e o layout responde à largura/altura do terminal;
6. **cor tem significado operacional**: fundos neutros em repouso; cor saturada reservada a atenção, crítico e interação.

A estrutura original analisada nos arquivos de referência concentrava árvore, tabelas, telemetria, configuração, eventos e linha de comando simultaneamente e possuía dezenas de atalhos. O desenho adotado substitui essa concentração por telas de contexto e por um conjunto pequeno de ações globais. O documento de referência anexado especifica essa direção, inclusive a organização em telas cheias, a redução de atalhos e a paleta industrial.

## Arquitetura da apresentação

```text
┌─────────────────────────────────────────────────────────────────┐
│ Apresentação Textual                                             │
│ app.py       ciclo de vida, navegação e execução de ações       │
│ screens.py   telas cheias                                       │
│ dialogs.py   decisões modais curtas                              │
│ widgets.py   componentes responsivos                            │
│ app.tcss     layout e pontos de quebra                          │
│ palette.py   identidade visual                                  │
├─────────────────────────────────────────────────────────────────┤
│ Apoio à apresentação                                             │
│ presentation.py    condição, rótulos e formatação pt-BR         │
│ command_catalog.py catálogo declarativo de ações                 │
│ spectrum.py        gráfico e metadados FFT                       │
│ preferences.py     preferências não sensíveis                    │
├─────────────────────────────────────────────────────────────────┤
│ Domínio                                                          │
│ core/models.py, core/state_store.py, services/controller.py      │
├─────────────────────────────────────────────────────────────────┤
│ Protocolo e transporte                                           │
│ protocol/*, serial_client.py, event_bus.py, events.py            │
└─────────────────────────────────────────────────────────────────┘
```

Fluxo de atualização:

```text
serial → DecoderRouter → EventBus → DomainController → StateStore
                                                   │
                                 snapshot enxuto   ▼
PicoTuiApp._refresh_ui ───────────────────────→ tela visível
```

A interface recebe cópias do estado. Widgets não alteram diretamente `StateStore`; ações voltam ao app e são traduzidas para comandos de protocolo. O ciclo visual usa `REFRESH_SECONDS = 0.5`. O snapshot usado pela apresentação limita históricos de telemetria e quadros recentes para evitar copiar buffers inteiros a cada atualização.

## Navegação

A base da pilha é sempre `HomeScreen`:

```text
Início
├── Módulo NN
│   └── Sensor NN.CC
│       └── Espectro FFT
├── Comandos
├── Rede CAN
├── Mensagens
├── Sensores sem fio
├── Métricas da rede
├── Ensaios
├── Pesquisa (/, fora da barra de teclas)
└── Ajuda
```

`Enter` abre o item realçado. `Esc` volta. `F2`/`i` retorna diretamente ao Início. Rede, Mensagens, Sensores sem fio, Métricas e Ensaios são telas de primeiro nível: a TUI substitui a tela de primeiro nível atual em vez de empilhar cópias indefinidamente.

### Teclas globais

| Teclas | Ação | Método principal |
|---|---|---|
| `F1` / `?` | Ajuda | `action_show_help` |
| `F2` / `i` | Início | `action_go_home` |
| `F3` / `p` | Conectar/trocar porta | `action_connection_setup` |
| `F4` / `c` | Comandos | `action_open_commands` |
| `F5` / `r` | Rede CAN | `action_show_network` |
| `F6` / `m` | Mensagens | `action_show_messages` |
| `F7` / `w` | Sensores sem fio | `action_show_wireless` |
| `F8` / `b` | Métricas da rede | `action_show_metrics` |
| `F9` / `e` | Ensaios | `action_show_experiments` |
| `F12` / `v` | Supervisório | `action_show_supervisor` |
| `F10` / `q` | Sair com confirmação | `action_exit_confirm` |
| `k` | Lançador de comandos (fora da barra de teclas) | `action_command_launcher` |
| `/` | Pesquisa (fora da barra de teclas) | `action_show_research` |
| `Esc` | Voltar | `BaseScreen.action_back` |
| `Ctrl+C` | interromper stream no sensor USB direto | tratamento em `on_key` |

`Ctrl+A` continua aceito como alias compatível para abrir Sensores sem fio, mas não faz parte do fluxo que o operador precisa memorizar. O caminho oficial é `F7`/`w`, exibido na barra de teclas e na Ajuda.

Quando um `Input` possui foco, letras são entrada de texto e não atalhos globais.

`k` e `/` não aparecem na barra de teclas, para não poluir a operação normal; estão na Ajuda.

### Lançador de comandos — `CommandLauncher` (`k`)

Uma linha de entrada no alto da tela, como um lançador de aplicativos. O operador digita o comando, por exemplo `22 00 FF 11`, e `Enter` o envia à rede e fecha a janela; `Esc` fecha sem enviar. Abaixo da linha, a janela diz o que vai acontecer: comando CAN de quatro bytes (com a ação do catálogo correspondente, se houver), texto para a Probe 00 (`ECHO`, `FAULT`, `CONFIG`, `BENCH`, `CMD`, `WIRELESS`), comando interno da TUI (`:tel on`) ou texto enviado sem alteração. As setas para cima e para baixo percorrem os últimos 50 comandos da sessão. O texto segue o mesmo caminho do comando manual da tela de comandos, com as mesmas regras de autorização (`22 00`, `22 10`, `22 30` e `FAULT` exigem a chave física no modo `presence`).

## Barra de teclas

`KeyBar` fica presa ao rodapé. Cada tela monta somente as ações pertinentes. Os itens quebram como segmentos inteiros: `F7/w Sensores sem fio`, por exemplo, não é separado entre linhas. Os segmentos podem ser clicados em terminais com suporte a mouse.

## Tela Início — `HomeScreen`

Finalidade: informar condição geral e oferecer acesso direto aos equipamentos.

Seções:

| Seção | Conteúdo |
|---|---|
| Faixa de estado | condição global, conexão, CAN, contagem de equipamentos e segurança |
| Precisa de atenção | somente equipamentos com motivo relevante; do mais grave para o menos grave |
| Equipamentos | Nodes CAN e seus sensores lógicos |
| Rede CAN | estado, taxa e contadores essenciais |
| Conexão | estado, tipo, porta, quantidade de candidatos/associados wireless e última ação |
| Mensagens recentes | opcional; oculto por padrão |

O item de equipamento é navegável com `Enter`. Um sensor associado aparece abaixo do Node responsável somente depois da confirmação de associação publicada pelo Node.

Em operação normal cada módulo ocupa uma linha (condição, papel e estado); a segunda linha só aparece com um problema e diz o motivo. A contagem de sensores e o último contato do módulo saíram da lista: os sensores aparecem logo abaixo, e o estado já indica contato recente. Um sensor associado que ainda não tem canal de dados mostra em que etapa a criação está (`canal de dados: aguardando o sensor entrar na rede Wi-Fi do módulo, há 2 min 10 s`).

O resumo de sensores sem fio distingue **disponíveis** e **associados**. Um UUID disponível é contado uma vez mesmo que vários Nodes o observem.

## Tela Módulo — `NodeScreen`

Apresenta um Node CAN físico.

Seções:

- **Situação**: condição, comunicação, papel líder/seguidor, estado CAN, capacidades, firmware, protocolo, uptime e contadores;
- **Sensor local**: somente quando o módulo possui função local; para o caminho atual mostra perfil, `0xAA`, publicação, rodada e idade;
- **Sensores sem fio associados**: filhos lógicos do Node; `Enter` abre o sensor;
- **Descoberta sem fio**: estado de scan BLE e candidatos observados pelo Node, com UUID, perfil, RSSI e classificação do sinal;
- **Intercorrências**: diagnósticos e eventos relevantes do módulo.

A tecla `w` abre a visão centralizada de Sensores sem fio. `c` abre os comandos do módulo e `s` solicita atualização do estado.

## Tela Sensor — `SensorScreen`

A tela é orientada pelo tipo de sensor e, principalmente, pelo canal realmente disponível.

### Sensor com plano de dados

No acesso USB direto ao Pico W, ou pelo módulo CAN com sessão autenticada, a tela pode apresentar situação, modo, aquisição, telemetria, bateria, métricas de vibração, tendências, diagnósticos, estatísticas de sequência e configuração aplicada. Para os perfis `VIBRATION` e `ACOUSTIC`, FFT e métricas especializadas ficam disponíveis; um perfil sem tela própria mostra os campos recebidos em "Dados recebidos".

<!-- livro:inicio id="acustico-tela-sensor" capitulo="Sensor acústico INMP441" titulo="A tela do sensor" -->
### Sensor acústico (`ACOUSTIC`)

Para o INMP441 a tela troca as métricas de vibração por quatro blocos, montados por `pico_tui/acoustic_view.py` a partir das análises de `pico_tui/acoustics.py`:

- **Níveis sonoros**: LAeq do último segundo em destaque, LCeq/LZeq, LAF com máximo e mínimo, pico, crista e curtose, frequência dominante, centroide, planura, cobertura da FFT e ocupação do núcleo de DSP; barras das bandas de oitava (31,5 Hz a 16 kHz, a dominante realçada, "acima de fs/2" para as omitidas) e a tendência do LAeq.
- **Painel do modo**, com título e campos próprios:
  - *Exposição ao ruído (NR-15 e NHO-01)* — LAeq,T, duração, L10/L50/L90, doses com projeção para 8 h, nível médio da NR-15, LEX,8h, tempo até 100 % e o critério de decisão da NHO-01; tendência da dose;
  - *Diagnóstico de máquina* — fundamental, faixa de busca do tacômetro na configuração em uso, rotação estimada com média e dispersão, hipótese de motor de indução, harmônicos, proeminência tonal, estado da assinatura e escore de anomalia contra o limiar; tendência do escore;
  - *Eventos sonoros* — contagem, evento em curso, razão STA/LTA contra o limiar em dB, fundo, último evento, taxa recente, evento mais forte e SEL combinado da sessão; tendência da razão STA/LTA.
- **Leitura do ambiente**: frases curtas, da mais grave para a mais leve — exposição e critério da NHO-01, tacômetro e anomalia, microfone e sobrecarga, curva NC, distância de conversa, graves (LCeq − LAeq), impulsividade, variabilidade e caráter espectral.
- **Eventos registrados nesta sessão**: os eventos mais recentes, com classe, pico, SEL, duração, centroide e o que a classe costuma indicar.

A situação do sensor inclui o microfone (sinal presente e canal, sem sinal válido ou em sobrecarga) e, na conexão USB, a plataforma (Pico W ou Pico 2 W). Microfone sem sinal é condição crítica; sobrecarga, dose no limite e anomalia pedem atenção. Cada uma dessas transições, o fim de cada evento (uma linha por classe, com contagem) e a assinatura pronta viram intercorrências.

Teclas próprias: `f` espectro em dB SPL, `z` reiniciar a medição e, no modo de máquina, `a` aprender a assinatura normal. Na tela Comandos o perfil acrescenta reiniciar a medição, aprender e descartar a assinatura e calibrar com calibrador; a configuração usa os modos, as taxas de WS e os pontos de FFT do INMP441 e propõe o limiar padrão de cada modo (3 em Máquina, 8 em Eventos). Na lista de equipamentos o sensor mostra LAeq e, conforme o modo, a dose, a rotação e o escore ou a contagem de eventos.

A demonstração (`--demo`) inclui um sensor acústico no Módulo 22 que reage a modo, taxa, FFT, limiar, reinício da medição, assinatura e calibração. A análise completa e as referências normativas estão em [`../sensor-acustico/sensor-acustico.md`](../sensor-acustico/sensor-acustico.md), seção 10.
<!-- livro:fim id="acustico-tela-sensor" -->

### Sensor wireless associado via Node CAN

A tela acompanha o estado do plano de dados informado pelo Node responsável (`WIRELESS_LINK`) e, desde a v0.22, as etapas da criação do canal (`WIRELESS_EVENT`).

Enquanto o canal não está completo, a seção **Criação do canal de dados** lista as etapas do vínculo à primeira leitura no CAN: vínculo confirmado, ponto de acesso no ar, oferta anunciada por BLE, sensor na rede Wi-Fi do módulo, HELLO conferido, sessão autenticada e primeira leitura (o painel não tem esta última). Cada etapa concluída traz a hora e os segundos desde o vínculo; a etapa atual diz há quanto tempo espera; a que falhou diz o motivo (chave que não confere, CHALLENGE sem resposta, ponto de acesso desligado, sensor chamando outro módulo). Abaixo vêm **O que verificar**, com a ação para aquela etapa, e os últimos relatos do módulo. Com um módulo de firmware anterior as etapas são deduzidas do estado do enlace, sem os motivos. Detalhes em [`../arquitetura/plano-de-dados-wireless.md`](../arquitetura/plano-de-dados-wireless.md), seção 7.

Sem sessão autenticada, a seção Situação mostra o vínculo e o motivo:

```text
Vínculo wireless     ONLINE via Módulo 04
RSSI do vínculo      -52 dBm
Plano de dados       Módulo anunciando a oferta ao sensor
Telemetria           Aguardando sessão autenticada com o módulo
Perfil               Vibração
Identificador        0xE6616408432B6F39
```

Os estados possíveis são: sem informação do módulo, sem canal de dados, módulo anunciando a oferta ao sensor, autenticação em andamento, sessão autenticada ativa e módulo sem chave de enlace. Este último também aparece na condição do sensor, porque exige ação de manutenção.

Nesse estado:

- `c`, `f` e `s` não são oferecidos como operações normais para o filho wireless;
- telemetria, FFT e configuração não aparecem na tela de comandos para esse alvo;
- a tela oferece `d Desassociar` e `w Sensores sem fio`;
- se uma chamada avançada tentar executar uma ação de dados, o app bloqueia e registra que o plano de dados está indisponível.

Com sessão autenticada, a tela é a mesma do acesso direto (situação, métricas, tendências, configuração) e a seção de comunicação passa a mostrar o enlace:

```text
Plano de dados              Sessão autenticada via Módulo 04
Sinal Wi-Fi                 -47 dBm
Sessão ativa há             312 s
Leituras no CAN             310
Perdidas no CAN             0 (0,00 %)
Perdidas no Wi-Fi           2
Rejeitadas (autenticação)   0
Rejeitadas (repetição)      0
```

`c`, `f`, `s` e `w` ficam disponíveis. Ações que só existem no console USB do sensor (reiniciar aquisição, ligar/desligar Wi-Fi, reler a lista de DTC) não são oferecidas pelo módulo. A queda da sessão e o aumento dos contadores de rejeição geram intercorrências.

O estado `ONLINE/STALE/LOST` do vínculo vem do Node responsável. A TUI não usa a idade local da última mensagem de associação para sobrescrever esse estado.

Essa decisão impede uma interface que aceite uma ação e não possua caminho físico/protocolar para entregá-la.

## Sensores sem fio — `WirelessScreen`

Esta é a interface oficial para descoberta e vínculo. Abre com `F7` ou `w` de qualquer tela de primeiro nível.

### Disponíveis

Candidatos são agrupados por UUID. Um UUID visto por quatro Nodes aparece uma única vez. Para cada candidato a TUI mostra:

- UUID;
- perfil;
- melhor Node por RSSI recente;
- RSSI dessa observação e qualidade textual (`bom`, `regular`, `fraco`);
- quantidade de Nodes observadores.

Somente observações recebidas nos últimos 15 s são oferecidas para nova associação. Isso evita associar a partir de uma observação antiga que permanece no modelo de sessão.

Ao realçar o candidato, a seção **Detalhes** mostra todas as observações recentes, ordenadas por RSSI. A primeira é a recomendação atual, mas o texto deixa explícito que a decisão não é automática.

`Enter` ou `a` inicia a associação.

### Escolha do Node

`WirelessNodeScreen` abre como diálogo e lista todos os Nodes que observaram o UUID recentemente:

```text
Módulo 04 · -52 dBm · melhor recepção
Módulo 03 · -58 dBm
Módulo 02 · -65 dBm
Módulo 01 · -78 dBm
```

O operador pode escolher qualquer um. Em seguida, `ChoiceScreen` pede a política de reassociação, o que também serve de confirmação:

```text
Associar com reassociação automática
Associar; só o operador muda o responsável
```

Só então a TUI envia:

```text
WIRELESS BIND <node> <uuid> [AUTO]
```

Com a reassociação automática, o líder da rede entrega o sensor a outro módulo que o alcance quando o responsável sai do ar ou deixa de ouvi-lo. A regra está em [`../arquitetura/metricas-e-ensaios.md`](../arquitetura/metricas-e-ensaios.md).

A TUI não cria o filho localmente no clique. O fluxo esperado é:

```text
pedido BIND
   ↓
ASSOCIATING
   ↓
BOUND
   ↓
ONLINE
   ↓
NN.CC aparece no estado
```

O menor `child_id` livre é alocado pelo Node, não pela apresentação.

### Associados

A lista mostra `NN.CC`, perfil, UUID, Node responsável, estado, RSSI do vínculo e a política de reassociação (automática, manual ou não informada, quando o firmware do Node é anterior à versão 0.18). `Enter` abre a tela do sensor.

`f` altera a política do sensor realçado (`WIRELESS POLICY <node> <uuid> AUTO|MANUAL`). A lista só mostra a nova política depois que o Node a confirma.

Quando o líder reassocia um sensor, o filho muda de `NN.CC`: o registro sob o módulo antigo é retirado assim que o novo módulo publica o vínculo, sem esperar um `UNBOUND` que não chega se o módulo antigo saiu do ar. A troca gera uma intercorrência nos dois módulos e uma mensagem de aviso.

`d` solicita desassociação. Antes do envio, `ConfirmScreen` descreve a consequência. A TUI envia:

```text
WIRELESS UNBIND <node> <uuid>
```

O filho **não** é removido de forma otimista. A interface aguarda a resposta do Node. Somente `UNBOUND` leva o `DomainController` a remover `NN.CC`. Se o Pico continuar anunciando, o UUID volta à lista Disponíveis e pode ser associado novamente.

### Estado de liveness

A associação e o liveness são responsabilidades do Node CAN:

```text
DISCOVERED → ASSOCIATING → BOUND → ONLINE
                                      │
                       15 s sem BLE   ▼
                                    STALE
                                      │
                       45 s sem BLE   ▼
                                     LOST
                                      │
                         BLE retorna  └──→ ONLINE
```

A TUI somente representa o estado recebido pelo CAN.

## Tela Comandos — `CommandScreen`

É o único lugar normal para comandos operacionais genéricos. O alvo pode ser Rede CAN, um módulo ou um sensor com canal suportado.

Ações são definidas em `command_catalog.py`, agrupadas em:

- **Consultar**;
- **Operar**;
- **Manutenção**.

Cada ação possui título em linguagem operacional, descrição, escopo, parâmetro opcional, confirmação opcional, perfis/módulos suportados e indicação de proteção.

A tela mostra:

- alvo atual;
- lista de ações válidas;
- explicação do efeito;
- linha CAN quando aplicável;
- exigência de autorização/confirmação;
- último envio.

`t` troca o alvo. `Enter` executa a ação realçada. `a` abre o campo **Comando manual (avançado)**.

Depois que o operador informa o parâmetro e confirma (quando a ação pede), a tela de comandos fecha e volta para a tela de onde foi aberta (a inicial, a do módulo ou a do sensor), para o operador acompanhar a reação; um aviso curto repete a ação enviada. Se ele desiste no parâmetro ou na confirmação, a tela continua aberta. O comando manual não fecha a tela.

Para um sensor wireless associado no modo Probe/CAN sem sessão autenticada, a lista de ações de dados fica vazia e a explicação informa o estado do plano de dados, indicando `F7/w` para gerenciar o vínculo. Com a sessão ativa, as ações são enviadas à Probe como `CMD TARGET=NN.CC ACTION=...` e o resultado chega em `ACK`.

### Comando manual

O campo manual é deliberadamente secundário e oculto por padrão. Texto sem `:` é enviado ao equipamento conectado. Texto com `:` executa comandos internos, entre eles:

```text
:status
:node 04
:node 04.01
:can 22 20 FF 00
:wireless
:bind [uuid] [módulo] [auto]
:unbind [uuid] [módulo]
:policy [sensor|uuid] auto|manual
:metrics [on|off|reset|export]
:ensaios [nome do ensaio|stop]
:export metrics
:tel ...
:fft ...
:dtc ...
:config ...
:connect ...
:disconnect
:reconnect
:snapshot
:security
:lock
:quit
```

Para o sensor acústico há também:

```text
:config [sensor] mode=EVENTS rate=16000 fft=1024 threshold=8
:measure reset [sensor]
:baseline learn [segundos] | :baseline clear
:cal [94|114]
```

Esses comandos existem para diagnóstico e automação manual; a operação normal não depende deles.

## Rede CAN — `NetworkScreen`

Mostra:

- estado do barramento;
- bitrate de arbitragem e, quando disponível, fase de dados;
- bus-off, error-passive e utilização;
- quadros e bytes recebidos/enviados;
- erros de CRC e interpretação;
- transferências em curso;
- dados da Probe 00;
- até 40 quadros recentes, com direção, ID, formato e bytes.

Não existe rolagem horizontal; linhas longas são quebradas.

A utilização e os indicadores de erro desta tela passam a vir da medição da Probe 00 (`BUS_STATS`) quando o firmware é da versão 0.18 ou posterior.

## Métricas da rede — `MetricsScreen`

Abre com `F8` ou `b`. Reúne o que é medido na sessão, em seções:

| Seção | Conteúdo | Origem |
|---|---|---|
| Barramento | ocupação na última janela de 1 s, pico de 100 ms, máximos da sessão, quadros por segundo, estado de erro do controlador, contadores, fila de recepção, transferências segmentadas; gráfico da ocupação por segundo | `BUS_STATS` da Probe 00 |
| Coordenação da rede | líder, período do sinal de presença, maior silêncio do líder, trocas de líder, eleições, pedidos de entrada, reassociações decididas, módulos em falha | linhas da Probe 00 |
| Comandos aos sensores | quantidade e tempo de resposta mínimo, médio, percentil 95 e máximo | `RTT_MS` das confirmações |
| Tempo de resposta no pior caso | ocupação do modelo, se todos os prazos são cumpridos, a mensagem de menor folga, capacidade restante | análise sobre `ID_STATS` |
| Enlaces sem fio | por sensor: estado, sinal Wi-Fi, tempo de ida e volta, intervalo da telemetria, amostras perdidas entre o Node e a Probe, sessões, tempo da última retomada | `WIRELESS_LINK` e chegada da telemetria |
| Acontecimentos | eleições, trocas de líder, módulos marcados em falha, reassociações | linhas da Probe 00 |
| Mensagens por identificador | por identificador CAN: nome, quadros na janela, intervalo mínimo e variação ou tamanho estimado da rajada, pior tempo de resposta | `ID_STATS` e análise |

`x` exporta as medições e os ensaios para `exports/` (um JSON e dois CSV). `z` zera os acumulados da sessão na TUI e na Probe 00.

A análise de tempo de resposta é uma estimativa a partir do tráfego observado e a tela diz isso. O método e as ressalvas estão em [`../arquitetura/metricas-e-ensaios.md`](../arquitetura/metricas-e-ensaios.md).

Sem `BUS_STATS` (Probe 00 com firmware anterior, sensor em USB direto), a seção Barramento informa que aguarda as medições; as seções alimentadas pela própria TUI continuam funcionando.

## Ensaios — `ExperimentsScreen`

Abre com `F9` ou `e`. À esquerda, a lista de ensaios; à direita, o que o ensaio realçado faz, o que mede e o que o operador precisa fazer depois. Abaixo, o ensaio em curso e os resultados dos ensaios concluídos.

| Ensaio | Comando |
|---|---|
| Queda do líder | `FAULT POWER_CYCLE <líder> <s>` |
| Queda de um módulo | `FAULT POWER_CYCLE <node> <s>` |
| Módulo congelado | `FAULT SILENCE <node> <s>` |
| Queda do ponto de acesso | `FAULT AP_OUTAGE <node> <s>` |
| Sessões descartadas | `FAULT DROP_SESSION <node>` |
| Carga de alta / baixa prioridade | `FAULT LOAD <pct> <s> HIGH|LOW` |
| Ensaio manual | nenhum; marca início e fim de uma falha provocada à mão |

`Enter` inicia: a TUI pede o módulo (com o mais indicado já realçado: o líder, ou um módulo com sensores sem fio), a duração e, nos ensaios de carga, o percentual; depois mostra o efeito e o comando e pede confirmação. O comando passa pelo `SecurityManager` como qualquer comando mutável.

Durante o ensaio, a tela mostra o tempo decorrido, as medidas já obtidas e os acontecimentos com o instante em relação ao início da falha. O ensaio termina sozinho depois da duração da falha mais um período de observação, ou com `s`, que também envia `FAULT CANCEL`. Um ensaio por vez.

O resultado é medido a partir das mensagens da rede. Uma medida que não pôde ser obtida aparece como "não observado", e não como zero. O maior intervalo sem telemetria conta a partir da última amostra recebida antes da falha, de sensores que vinham enviando nos 10 s anteriores ao ensaio. Um ensaio iniciado fora da tela (comando digitado no campo manual, reprodução de uma gravação) é reconhecido pelas linhas `FAULT_TX` e `FAULT_EVENT` e medido da mesma forma.

No modo demonstração a rede simulada não reage à falha; apenas o início, o fim e a carga no barramento são representados. Para ver um ensaio completo sem hardware, use a reprodução de uma gravação.

## Pesquisa — `ResearchScreen` (`/`)

Medições da instrumentação de pesquisa para o TCC, fora da entrega da disciplina e da operação normal: por isso a tela não está na barra de teclas. Só lê; os comandos que geram as medições são enviados pelo lançador (`k`), e a própria tela lista exemplos.

| Seção | Origem | O que mostra |
|---|---|---|
| Eco LOCAL e Eco SENSOR | `[GW] ECHO_START`, `ECHO`, `ECHO_DONE` | último trem de cada caminho: alvo, amostragem e semente, andamento, ecos sem resposta com IC 95 % de Wilson, média com IC 95 % (t), desvio, mediana, p95, p99, extremos e a série; no SENSOR, a parte Wi-Fi medida pelo Node e o restante (CAN e Node) |
| Sinal de presença do líder | `HEARTBEAT ... t_us=` | intervalos no relógio da Probe, desvio padrão (variação), desvio do período (p99 e máximo); uma troca de líder recomeça a série |
| Ocupação e carga de fundo | `BUS_STATS`, `FAULT_EVENT kind=BUS_LOAD` | ocupação média com IC, mediana, p95, máximo; carga pedida, prioridade, ocupação gerada, semente e hash da sequência |
| Custo da segurança e da ponte | `[GW] WIRELESS_STATS` | por sensor: HMAC na recepção e selo no envio, pior datagrama, CPU do handshake, ponte Wi-Fi → CAN |
| Custo da criptografia na Probe | `[GW] BENCH`, `BENCH_DONE` | média, mediana, p95, p99 e máximo de cada operação |
| Parâmetros da compilação | `[GW] CONFIG` | taxa do barramento, sinal de presença, L, H, T, PING, fim de sessão, IDs de carga |
| Trens de eco desta sessão | idem | os 12 últimos trens, com respostas, mediana, p99 e máximo |

As estatísticas usam as mesmas definições de `Pesquisa/iocpesquisa/estatistica.py` (percentil tipo 7, IC da média pela distribuição t, Wilson), conferidas por teste. Os números são da sessão; campanhas com repetições, comparações e proveniência continuam com `python -m iocpesquisa` (`Pesquisa/README.md`). `z` zera as medições; uma nova conexão ou uma gravação também zeram.

## Supervisório — `SupervisorScreen`

Abre com `F12` ou `v` (`pico_tui/supervisor.py`). Reúne até cinco painéis na mesma tela, para testar sensores enquanto se acompanha o uso da rede:

- **Rede e barramento**: ocupação, pico, quadros por segundo, estado de erro, uso do barramento pelos dados sem fio de cada módulo (identificador `0x380 + N`: quadros/s, kbit/s e fração do barramento), líder, módulos em falha e enlaces sem fio;
- **Módulos CAN**: condição, papel (líder ou seguidor) e número de sensores de cada módulo;
- **um painel por sensor**: condição, comunicação, modo, métricas principais do perfil, DTCs ativos, enlace e perdas, com tendência.

Cada sensor e cada painel de rede entram uma vez só; a escolha oferece apenas o que ainda não está na tela. A borda de cada painel toma a cor da condição do que ele mostra: âmbar em atenção e vermelho em crítico (a rede fica em atenção a partir de 40 % de ocupação ou com módulo em falha e crítica a partir de 70 % ou em erro passivo/bus-off). O painel em foco tem borda grossa.

| Tecla | Ação |
|---|---|
| `a` | adicionar painel (recusado com cinco) |
| `x` | remover o painel em foco |
| `Enter` | abrir a tela completa do painel: sensor, Métricas da rede ou Rede CAN (Esc volta ao supervisório) |
| `Tab` | próximo painel |
| `<` `>` | mover o painel em foco |

A grade se ajusta à largura: em tela larga, 2 painéis lado a lado, 3 em linha, 4 em 2×2 e 5 em 3 + 2; de 60 a 99 colunas, duas colunas; abaixo de 60, um painel por linha. O último painel ocupa as células que sobrarem. A composição fica em `supervisor_panels` no arquivo de preferências (`~/.config/iot-over-can/tui.json`) e volta na próxima sessão; um sensor ausente continua no painel, à espera de dados.

## Reprodução de gravações

```bash
cd Front
python -m pico_tui --replay replays/owner_failover.log --replay-speed 4
```

A TUI lê um arquivo com as linhas da Probe 00 e o instante de cada uma (`@<ms> <linha>`) e as entrega ao decodificador no ritmo gravado, multiplicado por `--replay-speed`. Nenhum comando é enviado: `_send_raw` registra o comando com a marca "gravação: não enviado". As durações medidas nas telas de métricas e de ensaios usam o relógio da gravação, de modo que não dependem da velocidade de reprodução.

As gravações em `Front/replays/` são produzidas pela bancada virtual (`Codigo/scripts/record_network_scenarios.sh`), que executa o firmware real do Node CAN.

Sessões reais também são gravadas: com o registro em arquivo ligado (padrão; `--no-file-log` desliga), cada conexão serial gera `logs/gravacao_<data>_<sessão>.log` no mesmo formato, com os comandos enviados como comentários (`# t=<ms> comando: ...`) e o modo pedido no cabeçalho (`modo=gateway`, `sensor` ou `auto`), que a reprodução respeita. O argumento de `AUTH ...` e valores de chaves do tipo `*KEY*=`, `*TOKEN*=`, `*SECRET*=`, `*PASS*=` e `*PIN*=` são gravados como `***` (`pico_tui/services/recorder.py`). Um problema visto na bancada física pode assim ser revisto na TUI e virar caso de teste.

## Alarmes por limiar

Na tela de um sensor, `l` abre os limites de alarme do perfil: RMS, PPV, curtose e fator de crista (vibração); LAeq, pico sem ponderação, doses NHO-01 e NR-15 e escore de anomalia (acústico). Campo vazio é métrica sem alarme. O alarme acende quando a leitura passa do limite e apaga quando volta abaixo de limite − histerese (5 % do limite para RMS e PPV, 1 dB para níveis, 0,5 para curtose e escore, 0,2 para crista; doses não têm histerese). Aceso, ele entra na condição do sensor (atenção) e, com ela, na faixa de estado, na tela Início e na borda do painel no supervisório; acender e apagar viram intercorrências, mensagens da fonte `ALARME` e um aviso na tela. Os limites valem de imediato para a última leitura, ficam em `alarm_limits` nas preferências e se aplicam também a sensores que ainda vão aparecer (`pico_tui/alarms.py`).

## Falhas internas

O barramento de eventos isola cada tratador: a falha de um não interrompe os demais. Ela vai para o registro do Python e, uma vez a cada 30 s por tratador e tipo de exceção, para as mensagens como erro da fonte `INTERNO`, para que um dado descartado por defeito não passe despercebido.

## Mensagens — `MessagesScreen`

Mantém o registro operacional da sessão separado do estado contínuo. A tela recebe até 2000 entradas em memória; o JSONL da sessão continua sendo o registro técnico completo.

Controles:

- `d`: mostrar/ocultar depuração;
- `h`: mostrar/ocultar Mensagens recentes no Início e persistir a preferência;
- `l`: limpar somente a visualização.

Mensagens repetitivas de manutenção, dados locais `0xAA` e linhas não interpretadas já classificadas como ruído não são promovidas ao registro operacional, embora continuem disponíveis no arquivo técnico quando pertinente.

## Espectro — `FftScreen`

Disponível quando o alvo realmente possui canal de dados e perfil compatível. O gráfico textual calcula sua largura a partir da área disponível. A tela apresenta espectro, picos e parâmetros. `n` pede novo espectro.

Para o sensor acústico as magnitudes são pressão eficaz (Pa) por faixa e o gráfico usa dB SPL (re 20 µPa), com os 60 dB abaixo do topo; os picos aparecem em dB SPL.

Para filhos wireless sem sessão autenticada, a ação FFT não é oferecida. Pelo módulo, o espectro chega reduzido ao número de faixas pedido e com as magnitudes reescaladas a partir do pico.

## Ajuda — `HelpScreen`

Documenta navegação, símbolos, telas e comandos internos avançados. `F7/w` aparece explicitamente como gerenciamento wireless.

## Diálogos

Todos são `ModalScreen` e deixam a decisão curta sobre o contexto atual.

### `ConnectScreen`

Mostra portas detectadas, caminho manual, tipo de equipamento e modo demonstração. Rótulos públicos usam Probe 00 e Pico W. O modo interno `gateway` continua aceito por compatibilidade; a CLI também aceita `--mode probe`.

A TUI é offline-first: falha de porta não encerra a aplicação.

### `ConfirmScreen`

Usado para saída e ações com consequência operacional. A ação destrutiva/arriscada usa botão de erro, e o foco inicial fica em Cancelar.

### `ParameterScreen`

Coleta um parâmetro validado para uma ação declarativa, como intervalo de liveness ou resolução FFT.

### `ConfigScreen`

Coleta modo, taxa, janela, tamanho, STA/LTA e ganho quando existe canal de configuração do sensor. Para o sensor acústico, os modos são Ocioso, Nível sonoro e exposição, Diagnóstico de máquina e Eventos sonoros; a taxa e os pontos da FFT são escolhidos entre os valores aceitos pelo INMP441, e o limiar muda de significado com o modo (escore z em Máquina, razão STA/LTA em Eventos).

### `TargetScreen`

Escolhe o alvo da tela Comandos.

### `WirelessNodeScreen`

Escolhe o Node responsável por um UUID disponível. Mostra RSSI de todas as observações recentes e marca textualmente a melhor recepção.

### `ChoiceScreen`

Lista curta de opções com título e explicação. Usada para a política de reassociação, para o módulo de um ensaio e para o percentual de carga.

## Layout responsivo

A TUI evita `DataTable` e outras estruturas que dependem de largura fixa para informações longas. Os widgets textuais derivam de uma base que calcula suas próprias linhas para a largura disponível.

Pontos de quebra:

| Classe | Condição | Comportamento |
|---|---|---|
| `bp-narrow` | largura < 60 | uma coluna, bordas laterais removidas, diálogos ocupam a largura |
| `bp-medium` | 60 ≤ largura < 100 | uma coluna com seções completas |
| `bp-wide` | largura ≥ 100 | duas colunas quando a tela possui duas áreas |
| `bp-short` | altura < 30 | menos espaçamento e diálogos compactos |

Componentes principais:

| Componente | Uso |
|---|---|
| `WrappedLines` | base de texto com largura conhecida |
| `FlowLine` | segmentos que quebram como unidades |
| `KeyBar` | barra contextual de teclas |
| `Breadcrumb` | caminho de navegação |
| `StatusBand` | condição global |
| `Fields` | pares rótulo/valor responsivos |
| `Paragraphs` | texto com continuação indentada |
| `StableOptionList` | lista atualizável sem perder seleção |
| `EquipmentList` | hierarquia visual módulo → sensor |
| `MessageLog` | registro com wrap vertical |

Não deve existir rolagem horizontal como solução de layout.

## Identidade visual — Aço industrial

A interface utiliza superfícies neutras e reserva cor para significado.

Tokens principais:

| Token | Valor | Papel |
|---|---|---|
| `BG_ROOT` | `#1F2429` | fundo |
| `BG_PANEL` | `#272D33` | seções |
| `BG_RAISED` | `#313840` | faixa neutra/diálogos |
| `BG_SELECTED` | `#2E4A66` | seleção |
| `TEXT_PRIMARY` | `#E3E7EB` | valores |
| `TEXT_SECONDARY` | `#B7C0C8` | apoio |
| `TEXT_MUTED` | `#8E99A3` | rótulos |
| `ACCENT_FOCUS` | `#5B9BE0` | foco/interação |
| `STATE_OK` | `#79B38A` | normal |
| `STATE_WARNING` | `#E8A317` | atenção |
| `STATE_CRITICAL` | `#F4706A` | crítico |

Condição usa símbolo e palavra:

| Nível | Unicode | ASCII (`--ascii`) |
|---|---|---|
| Sem dados | `○` | `-` |
| Normal | `●` | `o` |
| Atenção | `▲` | `!` |
| Crítico | `■` | `X` |

## Modelo de condição

`presentation.py` calcula a condição apresentada sem embutir regras nos widgets.

Para equipamentos com telemetria/estado genérico, `StateStore.refresh_freshness()` utiliza os limites do domínio correspondente. Para sensor wireless associado, existe uma exceção deliberada: `association_state` em `ASSOCIATING`, `BOUND`, `ONLINE`, `STALE` ou `LOST` impede o aging genérico; o Node associado é a fonte autoritativa.

DTC crítico, bus-off e comunicação perdida elevam para Crítico. DTC de aviso, stale, error-passive, saturação ou qualidade degradada elevam para Atenção. A condição geral usa a pior condição relevante sem contar várias causas do mesmo equipamento como equipamentos distintos.

## Intercorrências

`Incident` registra fatos relevantes por equipamento, como DTC, comunicação, sequência, saturação, STA/LTA e respostas de comando. A fila por equipamento é limitada e repetições próximas com a mesma chave são agrupadas. A interface mostra DTCs ativos e histórico recente sem repetir a mesma anomalia a cada amostra.

## Segurança na interface

`SecurityManager` é consultado antes do envio. Prefixos mutáveis incluem:

```text
22 00    eleição
22 10    administração de Node
22 30    liveness CAN
WIRELESS BIND / UNBIND / POLICY
FAULT ...
CMD ...
RESET / SET / APPLY / DTC CLEAR / WIFI ...
```

`22 20` e `METRICS ...` permanecem leitura. Se a autorização falhar, o comando é bloqueado; esconder a ação não é considerado mecanismo de segurança.

Em conexão USB direta, o firmware do Pico W ainda aplica sua própria sessão `AUTH UNLOCK` para comandos mutáveis.

## Preferências

Arquivo padrão:

```text
~/.config/iot-over-can/tui.json
```

Conteúdo não sensível:

```json
{
  "show_messages_on_home": false,
  "show_debug_messages": false,
  "ascii_symbols": false
}
```

Falha de leitura/gravação não impede a abertura; a TUI volta ao padrão e registra o aviso.

Opções de execução relevantes:

```text
--messages / --no-messages
--ascii
--preferences <arquivo>
--mode auto|probe|gateway|sensor
--security-mode off|presence|otp
--security-config <arquivo>
```

## Testes

A suíte possui testes de protocolo, estado, segurança, catálogo de comandos, preferências, intercorrências, associação wireless e interface. `test_layout_no_truncation.py` percorre telas em diferentes tamanhos para verificar ausência de conteúdo horizontalmente oculto. `test_tui_redesign_v016_contract.py` mantém contratos específicos desta organização: tela wireless visível, associação/desassociação, bloqueio de ações sem plano de dados e consistência da versão.

Na tela **Sensores sem fio**, os itens das listas não dependem da largura transitória informada pela `OptionList` durante o primeiro ciclo de layout. Cada candidato é apresentado em linhas semânticas curtas — UUID, perfil, melhor módulo/RSSI e número de módulos observadores — e cada vínculo associado usa linhas separadas para identificação, perfil/estado, UUID e módulo/RSSI. O estado vazio da lista de disponíveis também é composto em duas linhas curtas ("Nenhum sensor sem fio disponível." / "Observações dos últimos 15 s."), porque a frase anterior tinha 64 células e era, de fato, a origem das três falhas de layout em 48, 60 e 100 colunas. Dessa forma, tanto itens reais quanto estados vazios obedecem ao limite horizontal sem remover informação.

Execução:

```bash
./Codigo/scripts/test_tui.sh
```

A validação de layout deve incluir pelo menos 48×18, 60×24, 80×24, 100×30 e 160×48.

`test_acoustic_tui_v019.py` cobre o sensor acústico: as análises (exposição, curvas NC, conversa, tacômetro, eventos, calibração), os decodificadores da Probe e do console USB, o estado a partir da gravação `acoustic_sensor` da bancada virtual e as telas na demonstração e com um console INMP441 simulado (`fake_acoustic_firmware.py`).

`test_network_metrics_v018.py` cobre a versão 0.18 em quatro níveis: contrato do firmware; conferência da biblioteca C com referências em Python (duração de quadro, PDU autenticada); análise de tempo de resposta contra o exemplo publicado por Davis et al.; e ponta a ponta, entregando as gravações da bancada virtual ao decodificador, ao domínio, às métricas e ao registrador de ensaios. Um dos testes refaz as gravações e as compara com as versionadas. Os rótulos das seções em `Fields` não passam de 24 caracteres, para que a quebra de linha não intercale rótulo e valor.

## Capturas de referência

As capturas fornecidas com o redesenho foram consolidadas em:

```text
Documentacao/interface/img/
├── antes_140x45.png
├── antes_60x20.png
├── inicio_120x36.png
├── inicio_48x24.png
├── sensor_120x36.png
├── comandos_120x36.png
└── conexao_80x24.png
```

As imagens `antes_*` servem apenas para registrar o problema de densidade visual que motivou as regras de layout. A interface documentada neste arquivo é a interface atual.

## Limitações atuais

- telemetria e comandos do Pico W pelo módulo CAN, métricas, reassociação e ensaios ainda não foram validados em hardware;
- a variação de período medida pela Probe 00 inclui a latência do laço dela, da ordem de 1 ms;
- a análise de tempo de resposta usa o tráfego observado, não um pior caso de projeto;
- no modo demonstração a rede simulada não reage aos ensaios;
- o Node retoma os vínculos gravados 12 s depois de reiniciar; nesse intervalo o sensor aparece sem sessão;
- só os perfis `VIBRATION` e `ACOUSTIC` possuem visualização especializada de telemetria;
- as leituras acústicas (dose, curva NC, conversa, tacômetro) são indicativas: o INMP441 não é um medidor de nível sonoro normatizado;
- preferências e intercorrências do modelo visual não substituem o JSONL técnico da sessão;
- correlação completa de solicitação/resposta por transação ainda pode ser expandida.
