marcelo-carvalhop/iot-over-can/Documentacao/historico/img/antes_60x20.png

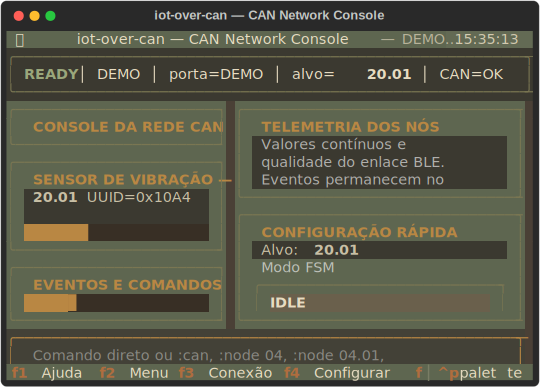
Documentacao/historico/img/antes_60x20.png
