marcelo-carvalhop/iot-over-can/Documentacao/historico/img/antes_140x45.png

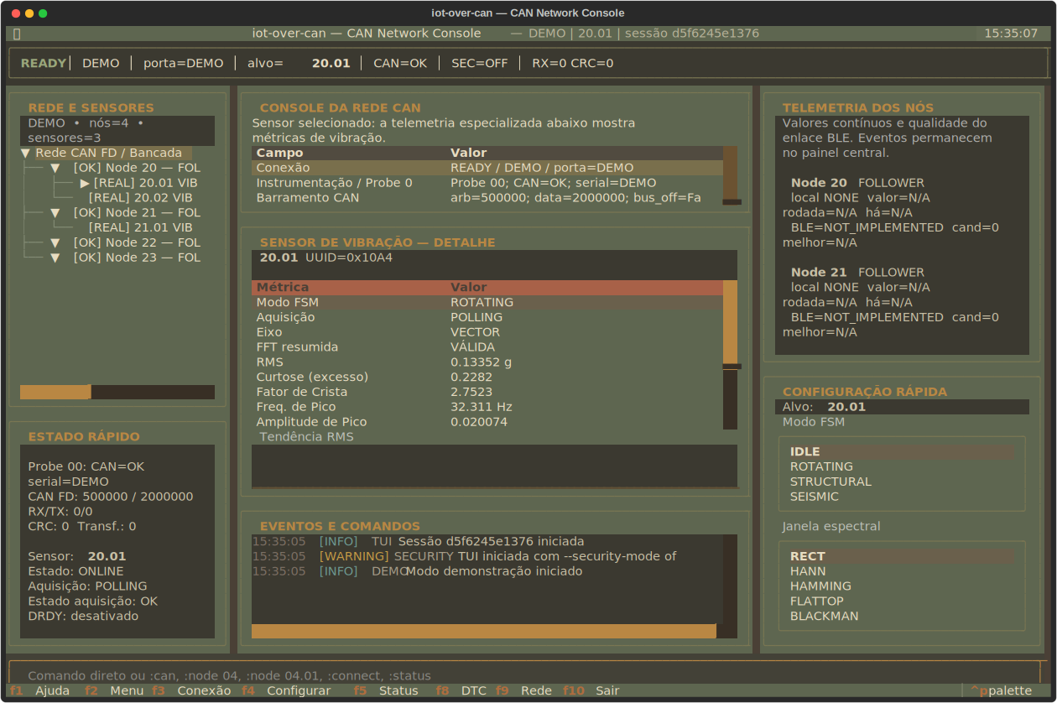
Documentacao/historico/img/antes_140x45.png
