marcelo-carvalhop/iot-over-can/Documentacao/historico/img/inicio_48x24.png

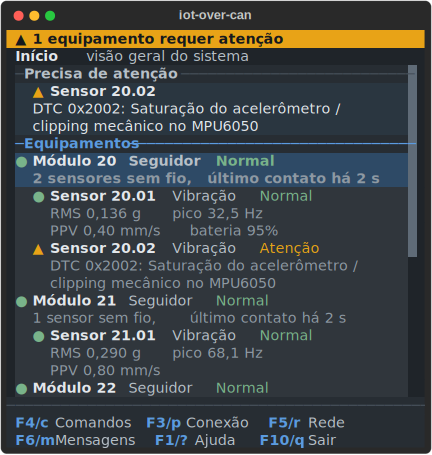
Documentacao/historico/img/inicio_48x24.png
