marcelo-carvalhop/iot-over-can/Documentacao/historico/img/inicio_120x36.png

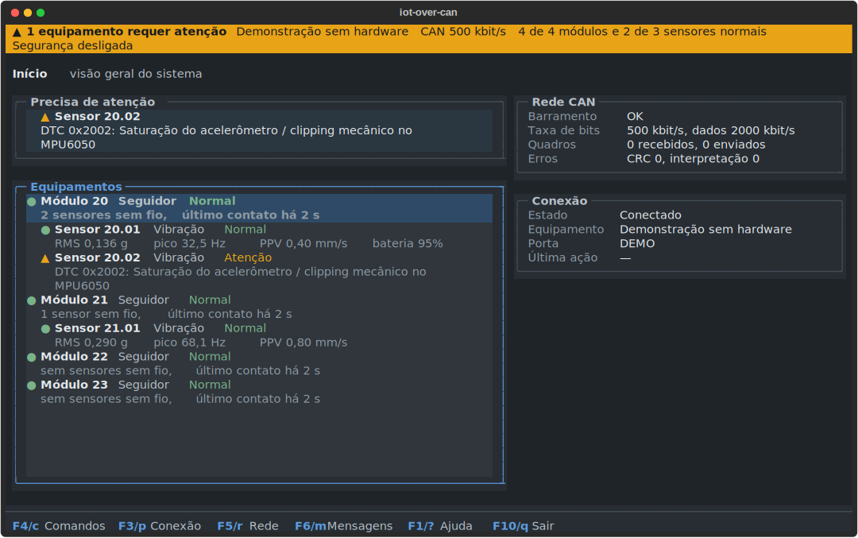
Documentacao/historico/img/inicio_120x36.png
