marcelo-carvalhop/iot-over-can/Documentacao/historico/img/sensor_120x36.png

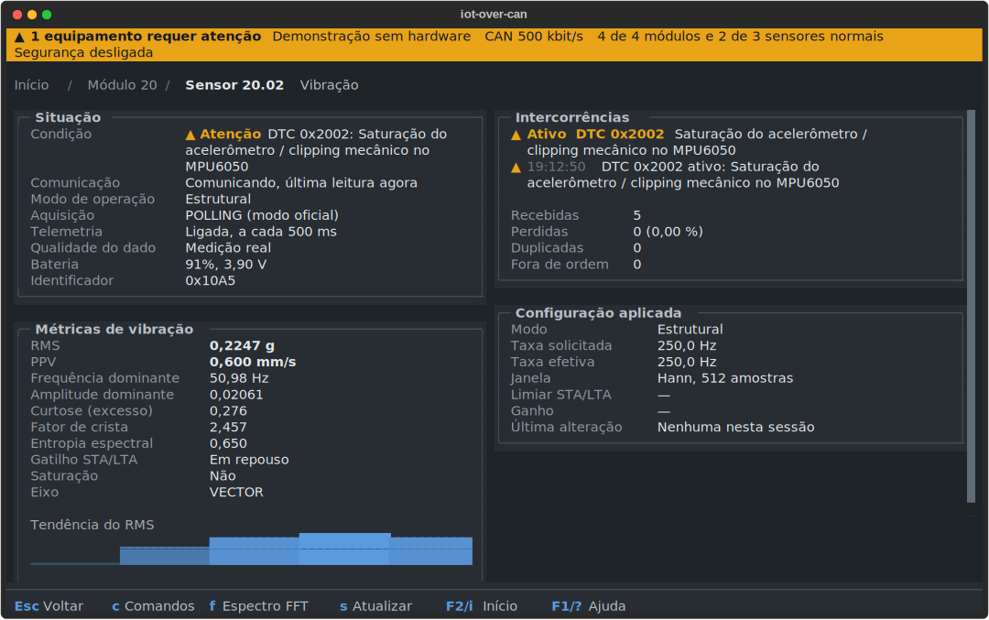
Documentacao/historico/img/sensor_120x36.png
