marcelo-carvalhop/iot-over-can/Documentacao/interface/img/comandos_120x36.png

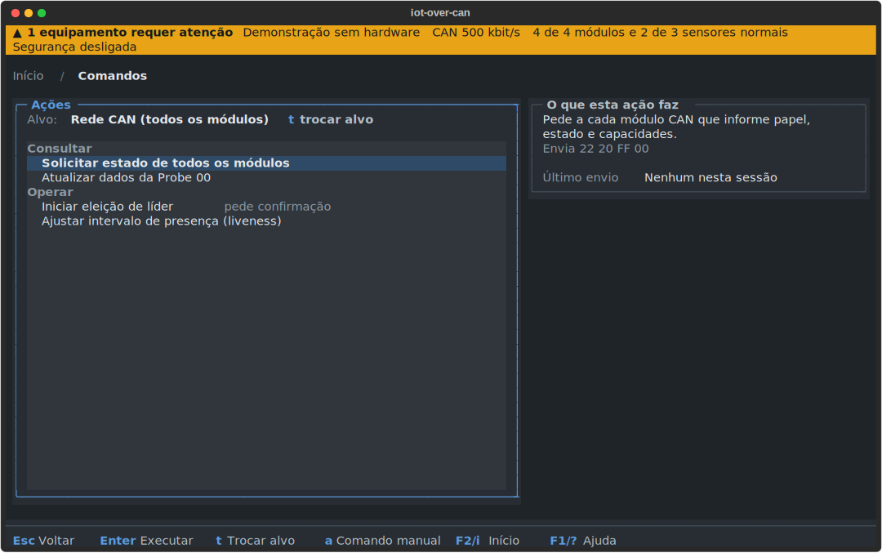
Documentacao/interface/img/comandos_120x36.png
