marcelo-carvalhop/iot-over-can/Documentacao/interface/img/conexao_80x24.png

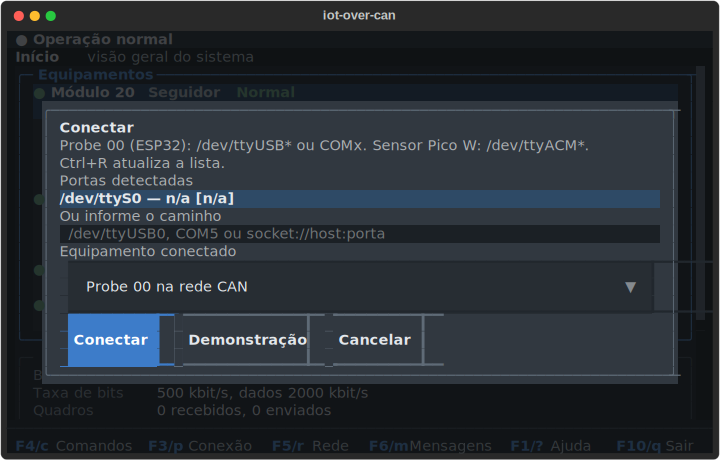
Documentacao/interface/img/conexao_80x24.png
