marcelo-carvalhop/iot-over-can/Documentacao/build_e_teste.md

# Build e teste

Os scripts operacionais ficam em `Codigo/scripts/` e são executados a partir da raiz do repositório.

## Primeira instalação, do zero

Sequência completa para colocar a bancada em funcionamento a partir de um computador sem nada configurado. As seções seguintes detalham cada parte.

### 1. Ferramentas no computador

| Para | Ferramenta |
|---|---|
| TUI | Python 3.11 ou superior |
| ESP32 (Probe 00 e Nodes) | PlatformIO Core: `python3 -m pip install platformio` (comando `pio`) |
| Pico W | Pico SDK 2.3.1 com submódulos, `PICO_SDK_PATH` apontando para ele, CMake 3.13 ou superior e o compilador `arm-none-eabi-gcc` |

### 2. Código

```bash
git clone https://github.com/marcelo-carvalhop/iot-over-can.git
cd iot-over-can
git switch feat/network-metrics-v0.18      # ou o branch que será gravado
git status                                 # "working tree clean"
```

### 3. Credenciais (uma única vez)

```bash
./Codigo/scripts/provision_sensor_security.sh
./Codigo/scripts/provision_sensor_security.sh --check
```

O primeiro comando gera, com permissão 600 e fora do Git:

| Arquivo | Conteúdo | Usado por |
|---|---|---|
| `.env.local` | token de manutenção e chave mestra do enlace (`EDGE_LINK_MASTER_KEY`) | build dos Nodes e do Pico W |
| `~/.config/iot-over-can/security.json` | token de manutenção | TUI |

**Nenhum outro script gera chaves.** Os scripts de build e de gravação apenas leem `.env.local`. Sem ele, o Node é compilado sem chave e só emite um aviso.

Se as credenciais já existem, o script não altera nada. `--add-link-key` acrescenta a chave mestra a um `.env.local` antigo. `--renew` troca todos os segredos e obriga a gravar de novo todos os Nodes e sensores. Para compilar em outro computador, copie `.env.local` e `security.json` para ele por um meio seguro; chaves geradas separadamente não conversam entre si.

### 4. Probe 00 e Nodes CAN

Um ESP32 por vez, cada um com seu identificador:

```bash
pio device list                                           # descobre a porta
./Codigo/scripts/upload_esp32_can_node.sh 0 /dev/ttyUSB0  # Probe 00
./Codigo/scripts/upload_esp32_can_node.sh 1 /dev/ttyUSB0  # Node 1
./Codigo/scripts/upload_esp32_can_node.sh 2 /dev/ttyUSB0  # Node 2
./Codigo/scripts/upload_esp32_can_node.sh 3 /dev/ttyUSB0  # Node 3
```

Use sempre o script. O botão de gravar do PlatformIO no editor não fornece identificador nem chave; desde a versão 0.18 a compilação sem `IOT_NODE_ID` para com erro, em vez de gravar a placa com um número qualquer.

Confira no monitor serial (`pio device monitor -b 115200`), logo após ligar:

- Probe 00: `[PROBE 00] FIRMWARE=...`;
- Nodes: `[WLINK] LINK_KEY=PROVISIONED`. `MISSING` significa que o Node foi gravado sem chave.

Durante a gravação, o script não deve mostrar `AVISO: chave de enlace ausente`.

### 5. Sensor Pico W

Na bancada, a forma mais simples usa a chave mestra:

```bash
./Codigo/scripts/build_pico.sh
```

O script deve informar `Enlace: chave mestra (bancada)`. Para gravar, segure o botão BOOTSEL do Pico W, conecte o USB e copie `Codigo/node-wifi/build/edge_node_firmware.uf2` para a unidade `RPI-RP2` que aparece.

Para um sensor de uso permanente, que não deve guardar a chave mestra, gere as chaves só dele. O UUID aparece no console serial do sensor com o comando `VERSION` (`NODE_UUID=0x...`) ou na tela Sensores sem fio:

```bash
./Codigo/scripts/provision_sensor_security.sh --sensor E6616408432B6F39
./Codigo/scripts/build_pico.sh --sensor E6616408432B6F39
```

e grave o novo `.uf2` da mesma forma.

O sensor acústico (INMP441) usa o mesmo procedimento com `--audio`, para Pico W ou Pico 2 W; a ligação do microfone está em [`sensor-acustico/sensor-acustico.md`](sensor-acustico/sensor-acustico.md), seção 2:

```bash
./Codigo/scripts/build_pico.sh pico_w --audio                        # bancada, chave mestra
./Codigo/scripts/build_pico.sh pico2_w --audio --sensor <UUID64>      # Pico 2 W, chaves só dele
```

O artefato é `Codigo/node-audio/build/edge_audio_firmware.uf2`; no Pico 2 W a unidade que aparece com BOOTSEL se chama `RP2350`.

### 6. TUI

```bash
./Codigo/scripts/setup_tui.sh                  # uma vez
./Codigo/scripts/run_tui.sh /dev/ttyUSB0       # porta da Probe 00
```

No modo padrão, comandos que alteram a rede (associação, eleição, ensaios) exigem a YubiKey conectada. Sem ela, na bancada: `SECURITY_MODE=off ./Codigo/scripts/run_tui.sh /dev/ttyUSB0`.

### 7. Colocar a rede no ar

1. Alimente os Nodes com uma fonte de 5 V capaz de 3 A ou mais (ver `modulo-can/modulo-can.md`, seção Alimentação), com o barramento terminado em 120 Ω nas duas pontas.
2. Na TUI, confira em **Início** os três Nodes e o líder. Sem líder, peça a eleição em **Comandos**.
3. Ligue o sensor. Em **Sensores sem fio** (`F7`/`w`), associe-o a um Node e escolha a política de reassociação.
4. Na tela do sensor, acompanhe o campo **Plano de dados** até "sessão autenticada ativa". Na serial do Node aparece `[WLINK] child=1 uuid=0x... SECURE`.

### Quando gravar de novo

| O que mudou | O que gravar |
|---|---|
| código do Node (troca de branch, correção) | todos os Nodes e a Probe 00, com a mesma versão |
| `.env.local` (`--renew`) | todos os Nodes e todos os sensores |
| código do sensor | os sensores |
| só a TUI | nada; basta reiniciá-la |

## TUI

Instalação/atualização do ambiente virtual:

```bash
./Codigo/scripts/setup_tui.sh
```

O script instala `Front/` em modo editável com as dependências de desenvolvimento de `Front/pyproject.toml`.

Execução offline-first:

```bash
./Codigo/scripts/run_tui.sh
```

A TUI abre mesmo sem hardware. Use `F3` ou `p` para escolher uma porta.

Execução com a Probe 00:

```bash
./Codigo/scripts/run_tui.sh /dev/ttyUSB0
```

Execução direta do pacote:

```bash
cd Front
source .venv/bin/activate
iot-over-can-tui --demo
iot-over-can-tui --port /dev/ttyUSB0 --mode probe
iot-over-can-tui --ascii
iot-over-can-tui --messages
```

`--mode gateway` continua aceito como alias interno de compatibilidade; a documentação usa Probe 00.

Testes completos:

```bash
./Codigo/scripts/test_tui.sh
```

A suíte inclui protocolo, estado, segurança, preferências, catálogo de comandos, intercorrências, associação wireless e contratos do redesenho. O teste de layout percorre múltiplas telas em 48×18, 60×24, 80×24, 100×30 e 160×48 para detectar conteúdo horizontalmente oculto/truncado.

Validação rápida de sintaxe sem abrir a TUI:

```bash
python -m compileall Front/pico_tui
```

## Validação manual da TUI

Com a Probe conectada:

1. abrir a TUI e confirmar que **Início** mostra condição, equipamentos, rede e conexão;
2. percorrer um módulo e voltar com `Esc`;
3. abrir `F4/c Comandos` e confirmar que ações têm descrição e alvo explícito;
4. abrir `F5/r Rede` e conferir barramento/quadros;
5. abrir `F6/m Mensagens` e conferir que DEBUG fica oculto por padrão;
6. abrir `F7/w Sensores sem fio` e confirmar que o mesmo UUID aparece uma vez em Disponíveis, com todas as observações nos detalhes;
7. associar escolhendo explicitamente um Node e acompanhar `ASSOCIATING → BOUND → ONLINE`;
8. realçar o sensor em Associados, pressionar `d`, confirmar e verificar que o filho só desaparece após `UNBOUND`;
9. se o Pico continuar anunciando, confirmar que o UUID volta a Disponíveis;
10. abrir o filho associado e acompanhar o campo **Plano de dados** até "sessão autenticada ativa"; antes disso, telemetria/configuração via Node devem aparecer como indisponíveis, sem ações falsas;
11. com a sessão ativa, conferir telemetria, pedir FFT e alterar a configuração, aguardando "Aplicada pelo sensor".

O roteiro completo da primeira validação do plano de dados está em [`arquitetura/plano-de-dados-wireless.md`](arquitetura/plano-de-dados-wireless.md), seção 10.

O alias `Ctrl+A` pode continuar abrindo o gerenciamento wireless, mas o teste operacional deve usar o caminho oficial visível `F7/w`.

## Node CAN — ESP32 + MCP2515

Build do Node 1:

```bash
./Codigo/scripts/build_esp32_can_node.sh 1
```

Upload do Node 2:

```bash
./Codigo/scripts/upload_esp32_can_node.sh 2 /dev/ttyUSB0
```

`IOT_NODE_ID` é fornecido pelo script. Não edite `main.ino` para mudar o ID. O ID 0 é reservado à Probe 00.

Os mesmos scripts leem a chave mestra do enlace de `.env.local` e a entregam ao build dos Nodes funcionais. Sem ela o firmware compila e funciona, mas com o plano de dados wireless desabilitado. A Probe 00 não recebe chave.

Monitor direto, quando houver porta disponível:

```bash
cd Codigo/node-can
pio device monitor -b 115200
```

O diagnóstico normal da associação pode ser feito pelo JSONL da TUI/Probe, sem exigir uma porta USB adicional para cada Node.

Opções de compilação do Node, passadas pela variável `PLATFORMIO_BUILD_FLAGS`:

| Opção | Padrão | Efeito |
|---|---|---|
| `-D IOT_FAULT_INJECTION=0` | `1` | remove o tratamento dos comandos de ensaio nos Nodes |
| `-D IOT_FOLLOWER_LEADER_WATCHDOG=0` | `1` | desativa a vigilância do líder pelos seguidores |

```bash
PLATFORMIO_BUILD_FLAGS="-D IOT_FAULT_INJECTION=0" ./Codigo/scripts/build_esp32_can_node.sh 1
```

A versão 0.18 muda o formato do estado de vínculo e do relatório de enlace no CAN. Grave todos os Nodes e a Probe 00 com a mesma versão.

## Sensor wireless — Raspberry Pi Pico W

Build de bancada (usa a chave mestra de `.env.local`, se existir):

```bash
./Codigo/scripts/build_pico.sh
```

Build para um sensor específico, apenas com as chaves derivadas para o UUID dele:

```bash
./Codigo/scripts/provision_sensor_security.sh --sensor E6616408432B6F39
./Codigo/scripts/build_pico.sh --sensor E6616408432B6F39
```

Artefato:

```text
Codigo/node-wifi/build/edge_node_firmware.uf2
```

O alvo operacional é `pico_w`.

<!-- livro:inicio id="acustico-build" capitulo="Sensor acústico INMP441" titulo="Compilação e gravação" -->
## Sensor acústico — Pico W ou Pico 2 W com INMP441

```bash
./Codigo/scripts/build_pico.sh pico_w --audio                      # Pico W (RP2040)
./Codigo/scripts/build_pico.sh pico2_w --audio                     # Pico 2 W (RP2350)
./Codigo/scripts/build_pico.sh pico_w --audio --sensor <UUID64>    # chaves derivadas para um sensor
```

Artefato:

```text
Codigo/node-audio/build/edge_audio_firmware.uf2
```

O código do diretório compila com `-Wall -Wextra -Werror`; o do SDK fica de fora. Os pinos do microfone podem ser trocados no CMake (`-DAUDIO_PIN_SCK=..`, `-DAUDIO_PIN_SD=..`; WS é sempre SCK + 1). As chaves e o token seguem exatamente o esquema do sensor de vibração, inclusive o arquivo `.env.sensor-<UUID>.local`.

Depois de gravar, no console USB (115200, qualquer terminal):

```text
EDGE> VERSION
VERSION PROTOCOL=6 NODE_UUID=0x... PROFILE=ACOUSTIC CHIP=RP2040 BOARD=pico_w
EDGE> STATUS
STATUS PROFILE=ACOUSTIC ... MODE=LEVEL ACQ=I2S RATE_HZ=16000.00 ... CHANNEL=LEFT MIC=OK CPU_PCT=.. COVERAGE_PCT=100 ...
EDGE> TELEMETRY ONCE
```

`MIC=OK` e `COVERAGE_PCT=100` confirmam a ligação e a folga de processamento. Sem sinal, o console escreve `[MIC] ... confira alimentação, SCK=GP18, WS=GP19, SD=GP20 e o pino L/R`.
<!-- livro:fim id="acustico-build" -->

## Testes nativos

```bash
./Codigo/scripts/test_native_firmware.sh
```

O script executa, no computador, sete verificações. Requer `cc` e `c++`.

1. Validação de configuração do sensor.
2. Biblioteca `ioc_link`: SHA-256/HMAC, autenticação do enlace, segmentação CAN, relatório acústico.
3. Biblioteca `ioc_link`, parte de rede: duração de quadro e CRC-15, PDU autenticada, segmentação em quadros de até 64 bytes e decisão de reassociação.
4. Fuzz determinístico dos decodificadores (`Codigo/common/tests/fuzz_ioc_decoders.c`): oferta BLE, envelope UDP, handshake, relatórios, remontagem de segmentos e PDU autenticada recebem entradas aleatórias e mensagens válidas mutadas, em buffers do tamanho exato, com AddressSanitizer e UBSan quando disponíveis (`fuzz_ioc_decoders <iterações> <semente>` roda campanhas maiores).
5. Sensor acústico (`Codigo/node-audio/tests`): motor de DSP e validação da configuração; o DSP roda também com AddressSanitizer e UBSan quando o compilador os oferece.
6. Simulação sensor ↔ Node ↔ Probe, que compila `Codigo/node-can/src/wireless_link.cpp` com os substitutos de `Codigo/node-can/test/host/stubs/`, com um sensor de vibração e um acústico.
7. Bancada virtual: a Probe 00 e três Nodes, cada um o firmware completo, em dezessete cenários (entre eles `acoustic_sensor`, com o sensor acústico, e `restart_keeps_binding`, em que o Node reinicia e retoma da NVS o vínculo gravado).

Para inspecionar a saída que a Probe 00 produziria:

```bash
./Codigo/scripts/build_wireless_link_sim.sh /tmp/sim_wireless_link
/tmp/sim_wireless_link

./Codigo/scripts/build_network_sim.sh /tmp/sim_network
/tmp/sim_network --list
/tmp/sim_network leader_failure --verbose      # inclui a serial de cada Node
```

### Gravações da bancada virtual

`Front/replays/` guarda a saída da Probe 00 em cada cenário. Os testes da TUI usam essas gravações e conferem que elas correspondem ao firmware atual. Depois de alterar o firmware do Node de um modo que mude o que a Probe escreve, refaça-as:

```bash
./Codigo/scripts/record_network_scenarios.sh
```

A TUI reproduz uma gravação sem hardware, com as telas de métricas e de ensaios funcionando sobre ela:

```bash
cd Front
python -m pico_tui --replay replays/owner_failover.log --replay-speed 4
```

## Validação wireless de bancada

Com o Pico anunciando:

- vários Nodes devem reportar o mesmo UUID com RSSI independente;
- o Node associado deve manter `ONLINE` enquanto recebe advertisements;
- após 15 s sem BLE, o vínculo passa a `STALE`;
- após 45 s desde o último BLE, passa a `LOST`;
- o retorno do Pico recupera `ONLINE` sem novo `BIND`;
- `UNBIND` deve produzir `UNBOUND` antes de a TUI remover o filho;
- após o `BIND`, o Node deve registrar `AP=ON` e, em seguida, `SECURE` para o filho;
- com o Pico desligado, o plano de dados deve voltar a `OFFERING` em cerca de 10 s e se recuperar sem novo `BIND` quando o Pico retornar.

O roteiro para métricas, vigilância do líder, reassociação e ensaios de falha está em [`arquitetura/metricas-e-ensaios.md`](arquitetura/metricas-e-ensaios.md), seção 9.

## Integração contínua

`.github/workflows/ci.yml` usa os scripts operacionais e executa os testes da TUI (entre eles a conferência da marcação do livro, `test_livro.py`), a validação nativa (com a bancada virtual) e os builds de firmware: Pico W (vibração), sensor acústico para Pico W e Pico 2 W, Node CAN e Probe 00. Scripts devem estar versionados como executáveis (`100755`), inclusive `extrair_livro.py`.

Verificação:

```bash
git ls-files -s Codigo/scripts/*.sh Codigo/scripts/*.py
```
