marcelo-carvalhop/iot-over-can/Codigo/node-wifi/edge_network_driver.h

/**
 * @file edge_network_driver.h
 * @brief Camada Wi-Fi/UDP de sessão autenticada com o Node CAN responsável (protocolo v0x06).
 * Atende ao Item 12: Arquitetura de Rede Híbrida.
 */
#ifndef EDGE_NETWORK_DRIVER_H
#define EDGE_NETWORK_DRIVER_H

#include <stddef.h>
#include <stdint.h>
#include <stdbool.h>
#include "edge_protocol_definitions.h"

// Maior payload interno (sem o envelope autenticado de 16 bytes) que cabe em
// um datagrama sem fragmentação IP. Conferido contra ioc_link.h no .c.
#define EDGE_NET_MAX_PAYLOAD_BYTES (NET_MAX_SAFE_PAYLOAD_BYTES - 16)

typedef enum {
    NET_STATE_DISABLED  = 0,
    NET_STATE_DISCOVERY = 1,
    NET_STATE_BOUND     = 2
} NetworkMode;

void        edge_net_init(void);
bool        edge_net_set_enabled(bool enabled);
bool        edge_net_is_enabled(void);
bool        edge_ble_beacon_is_active(void);
bool        edge_net_provision_wifi(const char *ssid, const char *password);
void        edge_net_clear_wifi_provisioning(void);
bool        edge_net_is_wifi_provisioned(void);
uint32_t    edge_net_next_discovery_delay_ms(void);
NetworkMode edge_net_get_state(void);
uint8_t     edge_net_parent_node_id(void);   // 0 quando não há Node responsável conhecido
uint8_t     edge_net_child_id(void);         // filho lógico atribuído na sessão atual
uint16_t    edge_net_auth_reject_count(void);
uint16_t    edge_net_replay_reject_count(void);
void        edge_net_poll_timeout(void);
void        edge_net_send_discovery_beacon(uint8_t bite_status);
// Envia um payload interno (DATA_UP) ao Node pai; false sem sessão ativa.
// Chamar do laço principal, nunca de uma ISR ou de callback do lwIP.
bool        edge_net_send_data(const void *inner, size_t len);
uint16_t    edge_net_next_seq(void);
void        edge_net_send_urgent_dtc(const DTC_Record *dtc_rec);
void        edge_net_send_config_ack(const Payload_Configuration *cfg, uint8_t status);
void        edge_net_send_dtc_snapshot(void);

#endif // EDGE_NETWORK_DRIVER_H
