marcelo-carvalhop/iot-over-can/(commit log)

2026-09-10 feat: establish validated pre-wireless baseline
    Reorganize the project into the academic repository structure, harden the Pico W firmware, fix DHCP support, consolidate documentation, and validate the CAN/TUI baseline before BLE integration.
    [__main__.py, app.py, battery_monitor.c, battery_monitor.h, can_ids.h, comandos.cpp, comandos.h]
2026-09-11 fix(tui): reduce telemetry noise and harden probe serial handling
    [app.py, btstack_config.h, can_ids.h, comandos.cpp, edge_ble_beacon.c, edge_ble_beacon.h, edge_network_driver.c]
2026-10-07 feat: authenticated wireless data plane through the CAN node (v0.17)
    Telemetry, spectrum, DTCs and configuration of an associated wireless
    sensor now travel Pico W -> responsible CAN node -> CAN -> Probe 00 -> TUI,
    and commands travel the other way.
    Link authentication (sensor protocol 0x06)
    - Key hierarchy K_master -> K_dev (per sensor) / K_net, HMAC-SHA256.
    - The responsible node advertises a signed BLE offer; the sensor derives
    the node's AP SSID/PSK locally and joins it.
    - HELLO/CHALLENGE/CONFIRM mutual authentication, per-session key, 32-bit
    anti-replay counter and 64-bit tag on every UDP datagram.
    - The v0x05 shared-key CLAIM and the unauthenticated UDP control build
    option are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
2026-10-08 v0.18: métricas da rede, ensaios de falha e reassociação automática
    Firmware (Node CAN e Probe 00):
    - Probe 00 mede o barramento: ocupação com a duração exata de cada quadro
    (CRC-15 e bits de preenchimento), pico de 100 ms, contadores de erro e
    intervalos por identificador (BUS_STATS, ID_STATS).
    - Tempo de ida e volta Node <-> sensor (PING/PONG) e comando -> confirmação.
    - Ensaios de falha pelo CAN (0x305/0x306): POWER_CYCLE, SILENCE, AP_OUTAGE,
    DROP_SESSION e carga artificial (0x010 / 0x7EF); removíveis com
    IOT_FAULT_INJECTION=0.
    - Reassociação automática autorizada por sensor, decidida pelo líder
    (0x302/0x303), com intervalo mínimo, prazo para ASSOCIATING e regra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
2026-10-08 docs: monitoramento da alimentação dos Nodes como trabalho futuro
    Registra o problema de alimentação observado na bancada (CH-053), o
    consumo típico com varredura BLE e ponto de acesso, como diagnosticar
    pelo motivo de reinício e a proposta de monitoramento em três níveis
    (motivo do reinício, tensão de entrada por divisor resistivo, corrente
    por INA219/INA226) e de ajustes de consumo no firmware.
    Claude-Session: https://claude.ai/code/session_01GKik5ZKP5e6VVBBLdtANPP
2026-10-08 docs: primeira instalação da bancada, do zero
    Sequência completa em build_e_teste.md: ferramentas, credenciais
    (o único passo que gera chaves), gravação da Probe 00 e dos Nodes pelo
    script, sensor Pico W em modo de bancada ou com chaves próprias, TUI,
    colocação da rede no ar e quando gravar de novo. Registra que o botão de
    gravar do PlatformIO no editor gera placas com identificador 4 e sem
    chave.
    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
2026-10-08 node-can: diagnóstico do enlace no monitor serial e RTT "sem medida"
    O Node passa a escrever no próprio monitor serial cada passo do enlace
    com o sensor: ponto de acesso no ar (com IP e porta), oferta anunciada
    ou falha ao anunciar, estação conectada/desconectada e IP entregue
    (eventos do Wi-Fi guardados em fila e impressos pelo laço principal),
    HELLO recebido e o resultado da conferência, CONFIRM sem correspondência
    e datagramas descartados. Recusas repetidas: no máximo uma por segundo.
    O relatório enviado quando o Node libera um vínculo passa a levar o
    tempo de ida e volta como "sem medida"; antes a TUI mostrava 0,0 ms
    (observado na primeira bancada física). Gravações da banc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
2026-10-08 sensor: diagnóstico no console; registro da primeira bancada física
    Sensor (Pico W): uma linha "[NET]" no console USB para cada mudança no
    caminho até a sessão com o Node (oferta conferida/aceita/ignorada,
    estado do Wi-Fi, IP e gateway obtidos, HELLO enviado, datagramas
    recebidos, recusas e sessão). Impressas pelo laço principal, só em
    mudanças. Protocolo inalterado. Compilado com Pico SDK 2.2.0 e 2.3.1.
    TUI: as linhas "[NET]" aparecem em Mensagens (INFO, origem REDE) e
    identificam o modo sensor direto.
    Node: a compilação sem IOT_NODE_ID para com erro em vez de gravar a
    placa como Node 4 (CH-057).
    Documentação: validacao-em-bancada.md com a sessão de 08/10/2026
    (plano de dad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
2026-10-09 docs: proposta de comissionamento de sensores sem compilação
    Registra como trabalho futuro a entrega da chave do enlace ao sensor
    pela rede: firmware único, código de instalação de 128 bits gerado na
    primeira partida e impresso em etiqueta, pacote com K_dev e K_net
    cifrado e autenticado com uma chave derivada do código, montado pela
    estação e entregue por CAN e anúncios BLE. Inclui papel dos Nodes e da
    estação, troca de chave como segunda etapa, limites (flash legível no
    RP2040, chave mestra nos Nodes), alternativas descartadas e decisões
    em aberto. Não implementado.
    Claude-Session: https://claude.ai/code/session_01GKik5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
2026-10-09 docs: ferramentas de simulação como trabalho futuro (prioridade muito baixa)
    Registra a recomendação de ferramentas abertas que complementariam a
    bancada virtual: ponte SocketCAN (vcan) com can-utils, python-can e
    Wireshark; Robot Framework ou pytest para os roteiros; GNU Octave para
    análise, varreduras de parâmetros e modelos; OMNeT++/FiCo4OMNeT para
    estudos de escala; Renode apenas para uma geração futura de hardware.
    Inclui por que as placas atuais não podem ser emuladas (rádios fechados
    do ESP32 e do CYW43).
    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
2026-10-12 refactor(node-wifi): ganchos edge_app e diagnóstico compartilháveis
    Prepara o firmware do Pico W para um segundo sensor sem duplicar o enlace:
    - edge_app.h define os ganchos que cada firmware implementa (perfil,
    menu de configuração, taxa e janela efetivas, fila de configuração e
    comandos próprios da sessão); edge_app_vibration.c guarda os do
    acelerômetro, inclusive o envio da telemetria.
    - edge_diagnostics.c/.h reúne os DTCs, o contexto de congelamento e a
    fila de alarmes urgentes, antes espalhados em main.c.
    - edge_network_driver expõe edge_net_send_data()/edge_net_next_seq() e o
    limite EDGE_NET_MAX_PAYLOAD_BYTES; o beacon BLE anuncia o perfil do
    firmware em vez de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
2026-10-12 feat(node-audio): firmware do sensor acústico INMP441 (Pico W e Pico 2 W)
    Novo firmware em Codigo/node-audio, com o mesmo enlace autenticado do
    sensor de vibração (perfil 0x02, PROFILE_ACOUSTIC_MEMS):
    - inmp441_i2s.pio/.c: I2S mestre na PIO (SCK/WS por side-set, 64 ciclos
    de SCK por quadro) e DMA encadeado em anel de 16 blocos, com reserva
    dinâmica de PIO/DMA para conviver com o CYW43; canal L/R detectado
    automaticamente (WS invertido no pino quando L/R está em VDD).
    - audio_core1.c: DSP no núcleo 1, comandos e relatórios por filas; o
    núcleo 0 fica com Wi-Fi, BLE, console e diagnóstico, e o watchdog só
    é alimentado enquanto o núcleo 1 dá sinal de vida.
    - acoustic_dsp.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
2026-10-12 feat(node-can): relatório acústico no plano de dados wireless
    - ioc_wdata: transferência IOC_WD_KIND_ACOUSTIC (108 bytes, 19 quadros
    CAN) com níveis em centésimos de dB e IOC_WD_CB_NA para o que o modo
    não calcula; ioc_wd_config passa a levar o perfil do sensor (formato
    v0.18, sem o perfil, continua aceito); opcode 0x21 (IOC_WD_OP_ACOUSTIC)
    para reinício da medição e assinatura de referência.
    - Node: guarda o perfil do HELLO autenticado, converte
    Payload_AcousticStream e encaminha o espectro pedido pelo mesmo caminho
    da vibração. Um SET MODE com nome de outro perfil é recusado
    (REASON=PROFILE_MISMATCH) e a edição inteira é descartada no APPLY.
    - Probe 00: linha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
2026-10-12 feat(tui): sensor acústico com análises próprias por modo
    A TUI passa a reconhecer o perfil ACOUSTIC (INMP441) pela Probe 00 e pelo
    console USB do sensor, com telas e análises equivalentes às dos modos do
    sensor de vibração:
    - Níveis sonoros: LAeq/LCeq/LZeq, LAF com máximo e mínimo, pico, crista,
    curtose, bandas de oitava em barras e tendência do LAeq.
    - LEVEL (exposição): doses NR-15 (q = 5) e NHO-01 (q = 3) com projeção
    para 8 h, tempo até 100 %, LEX,8h, nível médio e o critério de decisão
    da NHO-01.
    - MACHINE (diagnóstico): tacômetro acústico a partir da fundamental, com
    hipótese de motor de indução (polos e escorregamento), zumbido da rede
    de 60/120 H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
2026-10-12 chore: versão 0.19.0 (sensor acústico)
    TUI, biblioteca ioc_link e firmware do Node CAN passam a 0.19.0. A
    Probe 00 anuncia ACOUSTIC_DATA em FEATURES, já que o Node entende o
    relatório acústico (transferência do tipo 7). As gravações da bancada
    virtual mudam só na linha de versão da Probe.
    Claude-Session: https://claude.ai/code/session_01DzGgMGJ3M76tuFyMUePuvG
2026-10-12 feat(tui): faixa do tacômetro acústico e configuração completa na demonstração
    - acoustics.f0_range: a busca HPS do firmware vai de max(4·Δf, 20 Hz) a
    (N/2 − 2)·Δf/5; a tela do modo MACHINE mostra essa faixa (em Hz e rpm)
    e, sem fundamental, sugere reduzir a taxa ou aumentar a FFT.
    - Demonstração: taxa e FFT configuráveis; bandas de oitava acima de fs/2
    omitidas e fundamental encontrada só dentro da faixa, como no firmware.
    - ConfigScreen: ao escolher MACHINE ou EVENTS, propõe o limiar padrão do
    modo (3 e 8), sem sobrescrever um valor digitado.
    - Bancada virtual: o cenário acoustic_sensor usa 8 kHz e 2048 pontos no
    modo MACHINE, para que o motor de 1776 rpm caia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
2026-10-12 build: sensor acústico no build_pico.sh e na integração contínua
    build_pico.sh ganha --audio, que compila Codigo/node-audio
    (edge_audio_firmware.uf2) para pico_w ou pico2_w com as mesmas opções de
    credenciais do sensor de vibração. A CI compila o sensor acústico para
    as duas placas. Corrige a taxa efetiva citada nos comentários do driver
    I2S (48003,07 Hz no RP2040 a 125 MHz).
    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
2026-10-12 docs: sensor acústico INMP441 e marcação do livro do projeto
    - Documentacao/sensor-acustico/sensor-acustico.md: hardware e ligação,
    I2S na PIO e DMA, firmware em dois núcleos, cadeia de medição, modos
    LEVEL, MACHINE e EVENTS, configuração e calibração, transporte,
    diagnóstico, análises da TUI, validação e limitações.
    - Protocolo, arquitetura, plano de dados, TUI, build e testes, requisitos,
    estrutura, desafios (CH-058 a CH-066), READMEs e MANIFEST atualizados
    para a versão 0.19.
    - Livro: os trechos destinados ao livro ficam entre marcadores
    livro:inicio/livro:fim nos próprios documentos; Documentacao/livro.md
    define a convenção e o roteiro do capítulo "Se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
2026-10-12 fix(livro): texto dos links [`caminho`](caminho) acompanha o destino
    No rascunho, o destino de um link relativo era reescrito para o local de
    saída, mas o texto que repete o caminho continuava com o caminho antigo.
    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
2026-10-12 feat(tui): supervisório com até cinco painéis na mesma tela
    Nova tela (F12 ou v) que reúne, lado a lado, o painel "Rede e
    barramento" (ocupação, erros, líder, enlaces sem fio) e painéis de
    sensores, para testar sensores enquanto se acompanha o uso da rede.
    - Até cinco painéis; cada sensor e a rede entram uma vez só (a escolha
    oferece apenas o que ainda não está na tela).
    - a adiciona, x remove o painel em foco, Enter abre a tela completa
    (Esc volta), < e > reordenam.
    - Grade conforme a largura (3 + 2 com cinco painéis em tela larga, duas
    colunas em tela média, uma em tela estreita).
    - A composição fica em supervisor_panels nas preferências (tui.json) e
    volta na pr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
2026-10-12 fix(demo): módulos seguidores não envelhecem e pico limitado a 100 %
    Na demonstração só o líder mandava sinal de presença; os outros três
    módulos passavam a "sem dados recentes" em 10 s e a "comunicação
    perdida" em 30 s, e a faixa de estado acusava equipamentos em atenção
    sem motivo. Os seguidores agora se manifestam a cada segundo, exceto o
    módulo derrubado ou silenciado por um ensaio, enquanto o ensaio dura.
    O pico de ocupação em 100 ms da demonstração fica limitado a 100 %.
    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
2026-10-12 feat(tui): supervisório com módulos CAN, alarme na borda e uso do barramento
    - Painel "Módulos CAN": condição, papel e sensores de cada módulo
    (Enter abre a tela Rede CAN).
    - A borda de cada painel toma a cor da condição do que ele mostra
    (âmbar em atenção, vermelho em crítico); em foco, fica grossa sem
    perder a cor.
    - Rede e barramento: uso do barramento pelos dados sem fio de cada
    módulo (0x380 + N), em quadros/s, kbit/s e fração do barramento.
    - Painel de sensor mostra os DTCs ativos.
    - Robustez: teclas repetidas durante a reconstrução da grade não
    derrubam a tela; chaves inválidas ou repetidas no tui.json são
    descartadas, e itens não textuais da lista sã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
2026-10-12 test(ioc_link): fuzz determinístico dos decodificadores com ASan/UBSan
    Tudo o que chega pelo ar ou pelo barramento passa pelos decodificadores
    de Codigo/common/ioc_link antes de qualquer conferência de origem:
    oferta BLE, envelope UDP, HELLO/CHALLENGE/CONFIRM, relatórios do plano
    de dados (telemetria, espectro, acústico, ACK, DTC, enlace,
    configuração), remontagem de segmentos (8 a 64 bytes), comandos, PDU
    autenticada e custo em bits do quadro CAN.
    fuzz_ioc_decoders.c alimenta essas funções com entradas aleatórias e
    mensagens válidas mutadas, sempre em buffers do tamanho exato, e confere
    as invariantes (carga dentro do datagrama, bins do espectro dentro do
    buffer, remontagem dentr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
2026-10-12 feat(tui): alarmes por limiar, gravação de sessões reais e falhas visíveis
    - Alarmes por limiar (tecla l na tela do sensor): RMS, PPV, curtose e
    crista (vibração); LAeq, pico, doses NHO-01/NR-15 e escore de
    anomalia (acústico). O alarme acende acima do limite e apaga abaixo de
    limite − histerese; aceso, entra na condição do sensor (faixa de
    estado, Início, borda do supervisório), vira intercorrência, mensagem
    ALARME e aviso na tela. Limites valem já para a última leitura e ficam
    em alarm_limits nas preferências.
    - Gravação das sessões seriais reais em logs/gravacao_*.log, no formato
    de --replay, com os comandos como comentários e o modo no cabeçalho
    (a r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
2026-10-12 feat(node-can): vínculos gravados na NVS e retomados após reinício
    Um Node que reiniciava (queda de energia, watchdog, ensaio) perdia a
    tabela de vínculos, que existia só na RAM; com política MANUAL o
    operador precisava associar o sensor de novo.
    - ioc_bindstore (biblioteca comum): tabela versionada com o NODE_ID e
    CRC-32; a decodificação recusa a tabela inteira se algo não confere
    (marca, versão, outro Node, tamanho, CRC, UUID zero, filho fora da
    faixa ou repetido, UUID repetido). Testes nativos e fuzz com ASan/UBSan.
    - Node: regrava a tabela na NVS (Preferences, espaço ioc-bind) a cada
    associação, desassociação, mudança de política e vínculo cedido, fora
    de se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
2026-10-21 fix(tui): corrige falsos alertas e estabiliza operação direta do sensor acústico
    Corrige a avaliação de disponibilidade de sensores conectados diretamente
    via USB, impedindo que o contêiner lógico DIRECT_SENSOR_HOST seja tratado
    como um módulo CAN físico.
    Ajusta a classificação do estado operacional para eliminar notificações
    indevidas de equipamento crítico, preservando a detecção de falhas reais
    de comunicação, DTCs e condições anormais de funcionamento.
    Adiciona testes de regressão para os mecanismos de monitoramento de saúde
    e disponibilidade dos dispositivos.
    Validação funcional realizada com Raspberry Pi Pico W e INMP441,
    confirmando:
    - Telemetria acústica c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
2026-10-22 fix(simulacao): FFT do sensor acústico físico volta a chegar pela ponte USB
    A ponte USB do Studio tratava qualquer linha iniciada por "FFT " como
    resposta do Pico. O console do sensor ecoa o que é digitado, e o eco
    "FFT ONCE" era lido como FFT VALID=NO: cada nova tentativa gerava outro
    eco, a ponte desistia em milissegundos e a linha FFT VALID=YES, impressa
    só no relatório seguinte do DSP (até 1 s depois), era descartada. O Node
    encerrava o pedido com SENSOR_TIMEOUT após 5 s.
    - Só "FFT VALID=YES|NO" conta como resposta; o eco e o OK FFT_ONCE são
    reconhecidos e não consomem tentativas.
    - Nova tentativa apenas para um VALID=NO de verdade e se o próximo
    relatório couber no praz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
2026-10-22 test(usb-hil): valida eco do Pico sem reproduzir solicitações antigas
2026-10-22 test(studio): cobre ciclo de vida do inicializador da bancada
2026-10-22 fix(tui): sincroniza fila de histórico com flush e evita perda de eventos
2026-10-22 test(tui): cobre eventos concorrentes ao flush e falha de persistência
2026-10-22 fix(usb-hil): drena linhas já recebidas antes de bloquear na USB
2026-10-22 fix(studio): corrige rotulagem de dados físicos e remove instrução redundante
2026-10-22 fix(audio): limita ocupação da CPU antes de converter para uint8_t
2026-10-22 fix(metrics): pondera ocupação CAN pela duração real de cada janela
2026-10-22 docs(studio): distingue medição acústica física de carga CAN simulada
2026-10-22 fix(tui): limita buffers de fragmentos e valida CRC entre partes
2026-10-22 docs(auditoria): formata corretamente comandos e nomes de código
2026-10-25 Painel PaperColor: bancada virtual, ponte USB, Studio e TUI
    - Bancada: painel virtual com o PanelApp do firmware, relé USB para o
    PaperColor físico, comandos PANEL e o cenário panel_papercolor
    - Simulacao/usb_panel_bridge.py: a USB faz o papel do Wi-Fi; teste de ponta
    a ponta com um PaperColor escrito a partir da especificação
    - Studio: página do papel (virtual ou espelho), botões e notas
    - TUI: linhas PANEL, marcas do operador no histórico (faixa OPERATOR),
    ciclo de sono sem intercorrência
    - Página: sensores sem o Node responsável, estado do vínculo sem os
    sinalizadores AUTO e SECURE
    Claude-Session: https://claude.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
2026-10-25 test(paper): valida JOIN antes de READY e reconexão HMAC do PanelApp real
2026-10-25 test(paper): expõe diagnósticos nativos de linkedição e assert
2026-10-25 test(paper): vincula dependências reais de wdata e cálculo CAN no teste host
2026-10-29 Painel PaperColor: teclado, marcas na linha do tempo, LEDs e bipes, desligamento
    Teclado: o CardKB fica na Port A (Ex_I2C, G4/G5), que o M5Unified não
    inicia sozinho no PaperColor; sem M5.Ex_I2C.begin() nenhuma tecla era lida.
    O firmware agora inicia o barramento, procura o teclado a cada 2 s e registra
    na serial quando ele conecta ou some.
    Marcas: a primeira tecla abre uma marca naquele instante (a idade enviada
    conta desde ela); Enter grava o texto, Enter sozinho marca só o instante
    (FLAG), Esc cancela e uma nota esquecida é gravada após 90 s. #etiquetas
    viram "tags" no histórico da TUI; marcas do operador disparam captura da rede
    ao redor; m/M no histórico saltam entre as marcas.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
2026-10-29 Modelo de pesquisa: instrumentação, carga com semente, eco, custo da criptografia e análise
    Transforma a bancada num instrumento para uma pergunta comparativa: o custo
    da integração de sensores sem fio autenticados sobre o tráfego determinístico
    do CAN, em função da carga de fundo e da prioridade dela, e a reação da rede
    a falhas do enlace (Documentacao/pesquisa/metodologia.md).
    Firmware (Probe 00 e Nodes, v0.21.0):
    - relógio monotônico de 64 bits (esp_timer) e t_us nas linhas de eventos da
    Probe (HEARTBEAT, TEL, ACK, FAULT_*, WIRELESS_*, BUS_STATS), com domínios
    de relógio declarados;
    - ECHO <node>.<filho> <n> <período> LOCAL|SENSOR: ida e volta pelo caminho
    CAN do pl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
2026-10-29 Pesquisa: eco com amostragem de Poisson e fase da janela sorteada por repetição
    A primeira campanha virtual (840 execuções) mostrou um efeito espúrio: sem
    carga, a integração ligada parecia reduzir o p99 do eco de 2,57 para 1,57 ms.
    O trem de sondas de período fixo (500 ms) entrava em fase com o relatório do
    enlace do Node (5 s): uma sonda em cada dez caía sempre no mesmo instante dele.
    Como a bancada virtual é determinística, as 30 repetições eram a mesma
    execução (IC de largura zero, pseudorreplicação).
    - Probe 00: ECHO <node>.<filho> <n> <período_ms> [LOCAL|SENSOR] [semente].
    Com semente, intervalos exponenciais de média T limitados a [T/10, 5T]
    (RFC 2330); ECHO_S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
2026-10-29 Reassociação: não mover um sensor que reaparece antes de o responsável se manifestar
    A bancada virtual com fase sorteada encontrou uma disputa na política
    SENSOR_LOST (1 de 30 repetições de sensor desligado com 50 % de carga):
    quando um sensor LOST reaparece, todos os Nodes o observam quase ao mesmo
    tempo; a varredura de 1 s do líder caiu entre a observação do Node 2 (-68 dBm)
    e o novo estado do responsável (Node 1, -50 dBm), e o sensor foi movido para
    o Node de sinal pior (telemetria de volta em 16,8 s em vez de 1,5 s).
    - ioc_failover: em SENSOR_LOST, o destino precisa observar o sensor sem
    interrupção por IOC_FO_SETTLE_MS (6 s, mais que um ciclo de reenvio), e
    nada é dec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
2026-10-29 Pesquisa: figuras legíveis e relatório da campanha virtual de validação
    - Figuras do relatório em pequenos múltiplos: cauda do eco LOCAL (fração
    das sondas acima de x, escala log) por carga e prioridade, integração
    desligada e ligada; variação do sinal de presença com um ponto por
    repetição. Paleta de duas cores validada para daltonismo e contraste.
    - Legendas das figuras no relatório e ressalva sobre as fases fixas entre
    os Nodes na bancada virtual.
    - Documentacao/pesquisa/validacao-virtual: relatório, tabelas e figuras da
    campanha de 840 execuções no commit 347eddb (verificar sem problemas),
    com o que ela encontrou e os resultados preliminares a confirmar na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
2026-10-29 Pesquisa: tabelas CSV do relatório de validação
    As tabelas do relatório (condições e comparações) estavam fora do commit
    anterior por causa da regra *.csv do .gitignore; a exceção vale só para
    esta pasta.
    Claude-Session: https://claude.ai/code/session_01A9kefwdaFeXEQFRrfGS3rS
2026-10-30 Painel PaperColor: página de partida ao ligar e diagnóstico do papel na serial
    Ao ligar, a M5.begin limpa o papel com uma atualização completa (a tela pisca
    em todas as cores por 20 a 50 s e fica branca). Sem sessão com um Node, a
    primeira página só vinha 60 s depois do begin, quase 2 min após ligar, e o
    painel parecia não mostrar nada.
    - A página de partida ("Painel ligado", Node procurado, marca IoT-over-CAN)
    sai em toda partida pelo operador, não só depois de "Painel desligado".
    Ao acordar pelo RTC (bateria) nada muda.
    - Limite dos 60 s sem dados: a espera pelo retrato terminava em >= 60 s e a
    página "sem dados" só começava em > 60 s; no instante exato, o painel
    de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
2026-10-30 Plano de dados: sessão do sensor abre com rádio disputado e com vários sensores
    Na bancada física a sessão levava mais de 20 min para abrir e, com mais de um
    sensor, podia não abrir: o vínculo BLE existia, mas o handshake não avançava.
    Sensor (Pico W):
    - Um nonce por tentativa de autenticação, não por HELLO. O sensor repete o
    HELLO a cada 1,5-3,5 s; com um nonce novo a cada repetição, todo CHALLENGE
    atrasado mais que esse intervalo chegava com o eco de um nonce já trocado e
    era descartado. O nonce é refeito numa nova associação, depois de uma sessão
    ou a cada NET_HELLO_NONCE_MAX_USES (8) HELLOs sem resposta, e é decidido com
    o lock do lwIP.
    Node (ESP32), que d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
2026-10-30 Diagnóstico da criação do canal de dados na TUI
    O Node passa a relatar ao CAN cada etapa entre o vínculo e a sessão
    (transferência do tipo 10, [GW] WIRELESS_EVENT na Probe): ponto de acesso,
    oferta BLE, estações que entram e saem do AP, HELLO conferido ou recusado
    com o motivo, CHALLENGE sem resposta e sessão aberta ou encerrada. Fatos
    repetidos são agrupados (no máximo um relato a cada 5 s) e os relatos não
    tomam a fila da telemetria. Um HELLO de sensor não associado ao Node leva o
    UUID, para a TUI localizar o sensor que chamou o módulo errado.
    Na TUI:
    - tela do sensor: seção "Criação do canal de dados" com as etapas, a etapa
    em espera e há quanto tempo, o motivo da fa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
2026-10-30 Documenta a abertura do canal de dados como dificuldade de implementação
    desafios_e_resolucoes.md ganha a seção "Abertura do canal de dados
    wireless": sintoma, por que foi difícil (causas combinadas, sintoma que
    apontava para o lugar errado, rádio único do ESP32, bancada virtual sem
    atraso, falta de visibilidade na TUI), as três causas, a solução, o que
    falta medir na bancada física e as lições. CH-072 e CH-073 passam para essa
    seção. plano-de-dados-wireless.md ganha um resumo (seção 11) e o ponto de
    medição do tempo entre o vínculo e a sessão pela tela do sensor.
    Claude-Session: https://claude.ai/code/session_01A9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
2026-10-30 TUI: tela de pesquisa (/) e lançador de comandos (k)
    Tela Pesquisa, fora da barra de teclas e listada na Ajuda: eco LOCAL e
    SENSOR (perdas com Wilson, média com IC 95 %, mediana, p95, p99, parte
    Wi-Fi medida no Node), variação do sinal de presença no relógio da Probe,
    ocupação e carga de fundo com semente, custo da criptografia e da ponte nos
    Nodes (WIRELESS_STATS), BENCH CRYPTO da Probe e parâmetros da compilação
    (CONFIG). As estatísticas têm as mesmas definições de Pesquisa/iocpesquisa,
    conferidas por teste.
    Lançador de comandos: uma linha no alto da tela; Enter envia o texto à
    rede pelo mesmo caminho do comando manual (mesma autorização), Esc fecha,
    setas percorrem os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
2026-11-08 Painel na ESP32-2432S028 (CYD): LCD 320x240 com toque
    Mesmo PanelApp do PaperColor (enlace, retrato, relevância, marcas, LED e
    sons) com HAL próprio e página compacta: compõe a tela a partir da visão
    da rede e de ioc_page_assess e só redesenha o que mudou, no máximo 1 vez
    por segundo. Barra de toque com Situação, Rede, Marcar e Ciente.
    ST7789 por padrão (versão com USB-C e micro-USB), ILI9341 por
    -D CYD_PANEL_ILI9341=1; barras de cor na partida para conferir inversão e
    ordem RGB; calibração do toque gravada na NVS (BOOT ao ligar refaz).
    Ambiente pio 'cyd', build_paper.sh --cyd e compilação na CI. CH-074.
    Claude-Session: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
2026-11-08 Relógio da rede: hora UTC no CAN, sincronizada pelo terminal
    - Quadro de hora e de pedido de hora (ioc_time.h), um identificador por
    transmissor (0x120 + NODE_ID), abaixo da coordenação e acima dos
    sensores; fontes terminal, RTC e operador, com regra de adoção comum.
    - Nodes e Probe 00 (relogio.cpp): hora sobre o millis(), pedido na
    partida, resposta da Probe e do líder, comando TIME na serial;
    FEATURES ganha TIME_SYNC.
    - TUI: envia a hora do computador ao conectar numa Probe com TIME_SYNC
    e a cada 10 minutos; mostra os ajustes no registro.
    - Painel: pede a hora no HELLO (IOC_PANEL_HELLO_TIME) e a adota pela
    mesma regra; a CYD mostra a hora no cabeçalho.
    - Testes: formato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
2026-11-08 Documentação reorganizada e licença GPL-3.0
    - Documentação técnica concentrada em Documentacao/: README de
    apresentação e nove documentos (guia de uso, arquitetura, protocolo,
    integração, TUI, sensor acústico, segurança, validação e desafios),
    no lugar de cerca de 37 arquivos espalhados.
    - Novo guia de integração para quem for fazer um fork: mapa do código,
    receitas para sensores, mensagens CAN, telas e hardware, convenções.
    - Protocolo com o mapa completo de identificadores CAN e o protocolo do
    painel; painel documentado na ESP32-2432S028.
    - Documentos de etapas anteriores em Documentacao/historico/, sem
    revisão; material do TCC junto da ferramenta, em Pesqui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
2026-11-09 Leitor da documentação no M5Stack PaperColor
    O PaperColor sai da rede e passa a ser um leitor de bolso da
    documentação oficial (Codigo/leitor).
    - O README e os nove documentos de Documentacao/ vão gravados no
    firmware: tools/documentos.py converte os .md num cabeçalho C a cada
    compilação (cerca de 186 KB; o cartão SD não é necessário).
    - Diagramação própria (leitor_layout.*): quebra de linha, recuos, código,
    listas, tabelas em fichas e títulos que não ficam sozinhos no pé da
    página.
    - Telas Biblioteca, Seções e Leitura; A e C viram a página, B abre as
    seções, segurar pula de seção ou volta à biblioteca. Toques seguidos
    se somam num desenho só; nada m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
2026-11-12 Identificação do operador e trilha de auditoria no histórico
    Sem FIDO2 por enquanto, a estação passa a saber quem a está operando e
    registra quem alterou a rede ou autorizou a entrada de um sensor.
    Identificação
    - Login por senha na tecla `o` (diálogo OperatorScreen), com cadastro em
    ~/.config/iot-over-can/operators.json (0600, dono verificado, escrita
    atômica, falha fechada), senhas com scrypt e verificação fictícia para
    usuário inexistente.
    - Papéis operador/observador, expiração por inatividade (--operator-idle),
    bloqueio progressivo após 5 senhas erradas e revogação das sessões
    abertas quando a senha, o papel ou o estado da conta mudam.
    - Modos auto/requir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
